ToddBailey/WTPA2/README.md

WTPA2
=====

Home of "Where's The Party At 2" code and project resources since October 2013
