ToddBailey/WTPA2/hardware/WTPA2_PCB.png

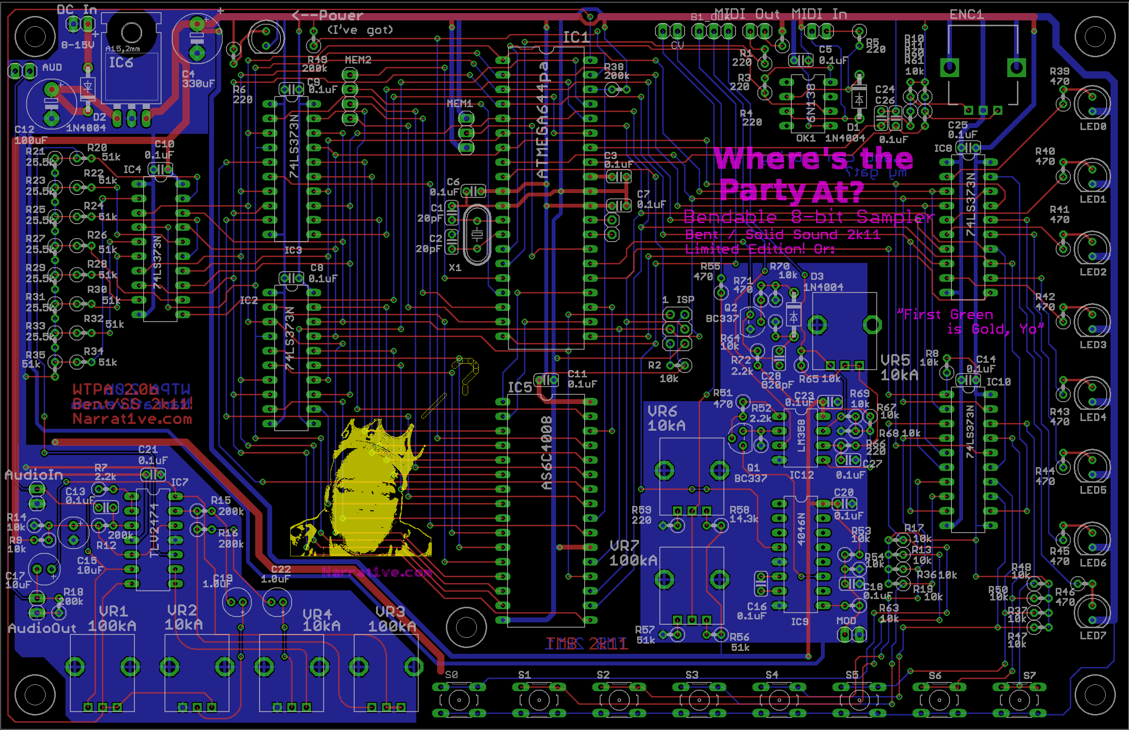
hardware/WTPA2_PCB.png
