ToddBailey/WTPA2/hardware/WTPA2_Schematic_P1.png

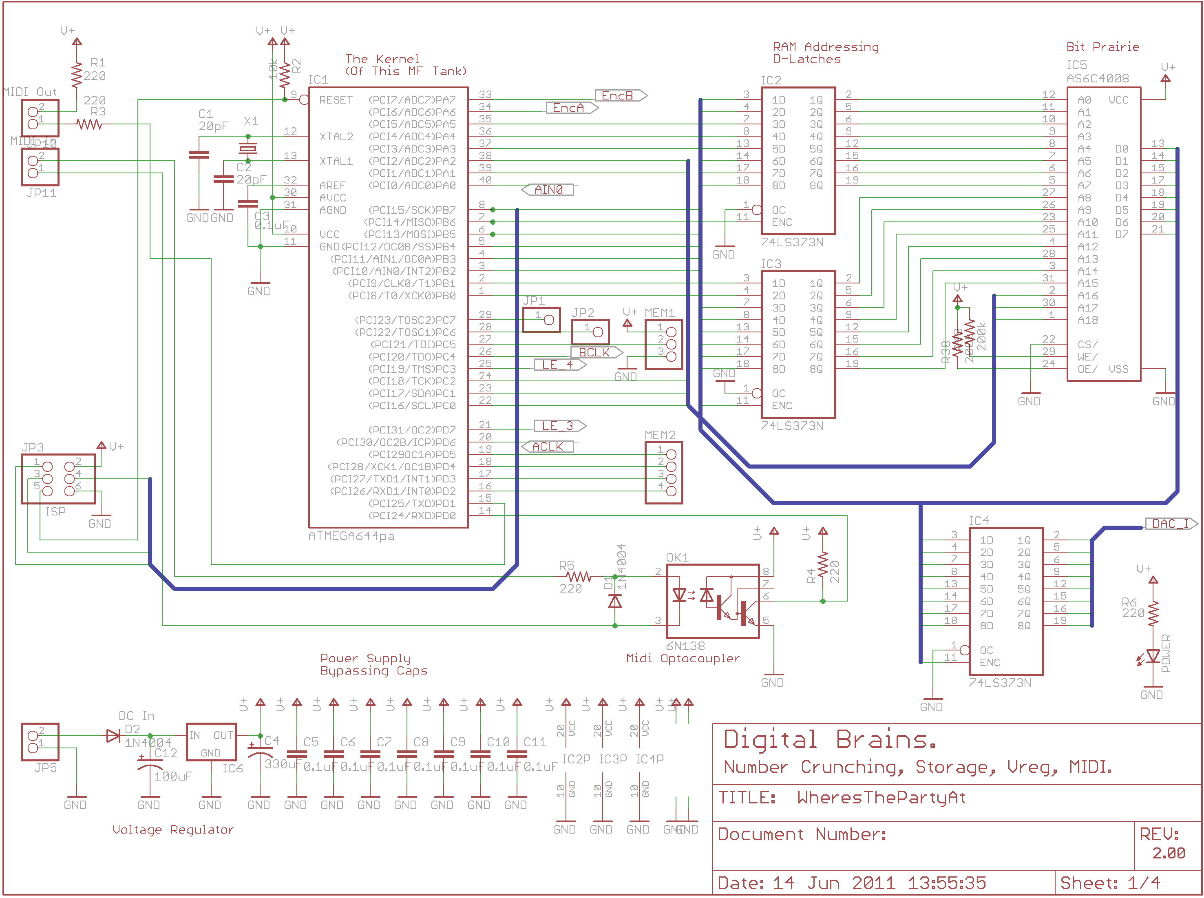
hardware/WTPA2_Schematic_P1.png
