ToddBailey/WTPA2/hardware/WTPA2_Schematic_P2.png

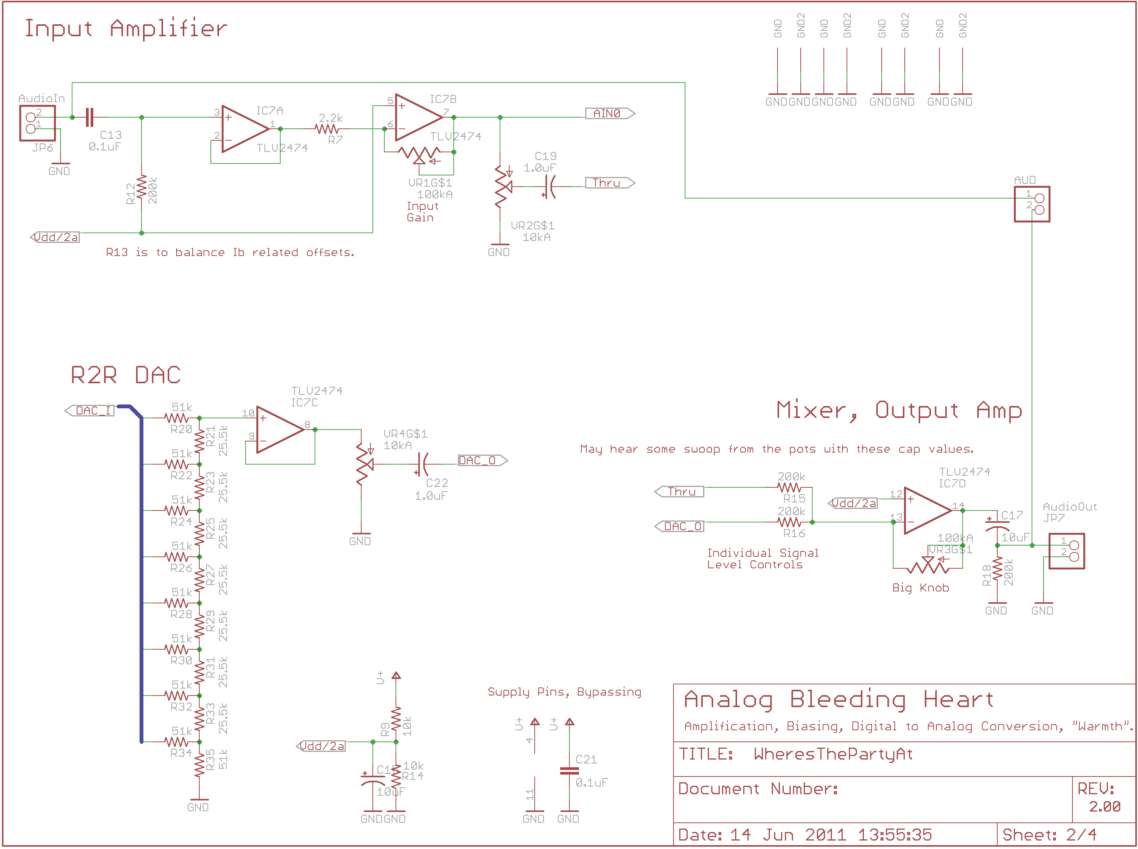
hardware/WTPA2_Schematic_P2.png
