ToddBailey/WTPA2/hardware/WTPA2_Schematic_P3.png

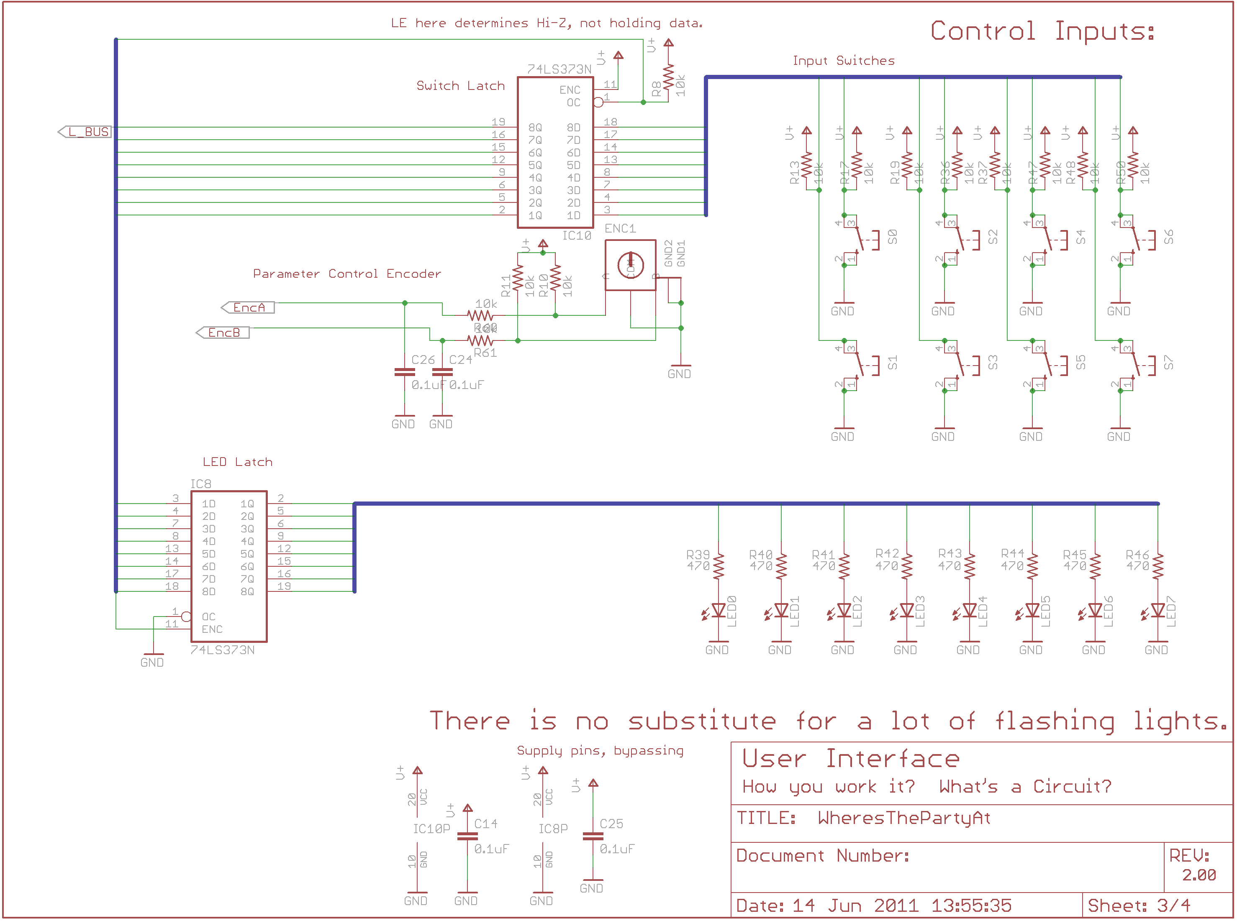
hardware/WTPA2_Schematic_P3.png
