ToddBailey/WTPA2/hardware/WTPA2_Schematic_P4.png

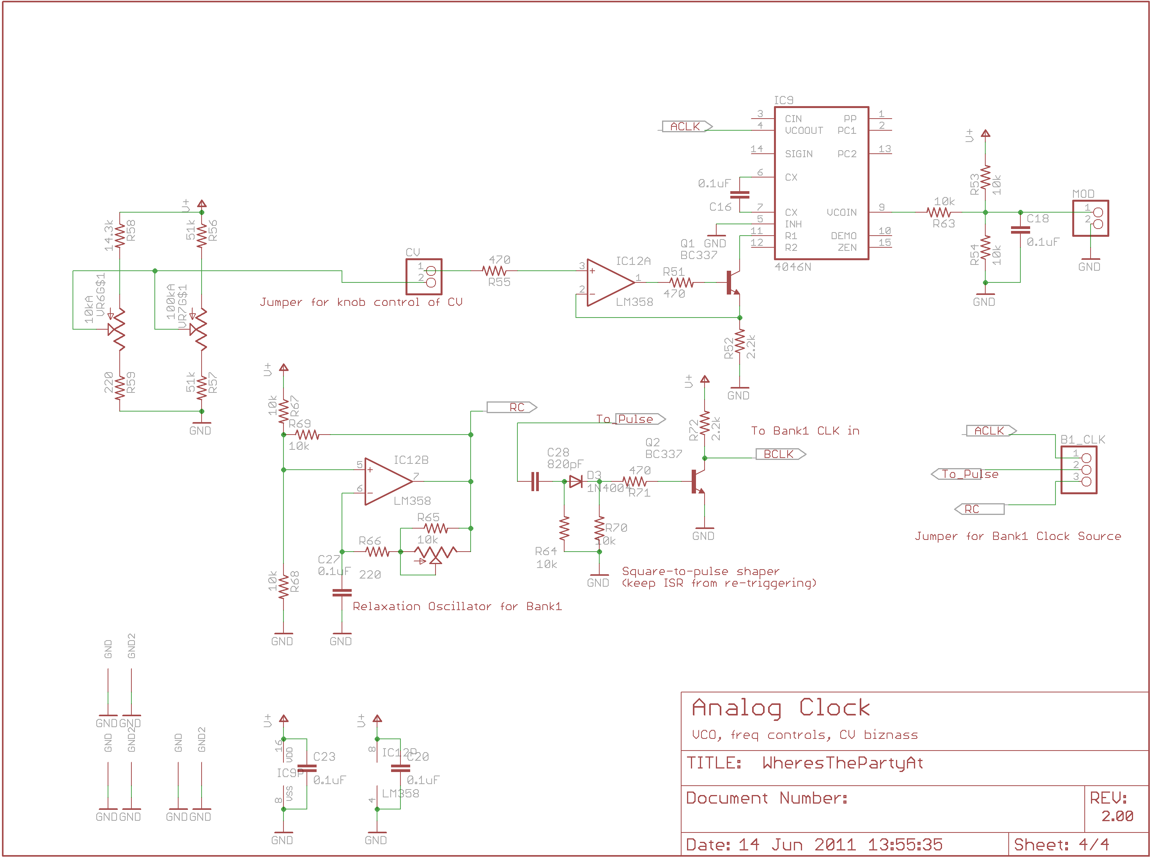
hardware/WTPA2_Schematic_P4.png
