ToddBailey/WTPA2/docs/WTPA2_Component_Guide_RevA.pdf

## WTPA2 Component Guide

(a gentle guide for the trepidatious) First Revsion (Rev A)
December 7 2014
TMB

This is basically a big set of descriptions and pictures of WHAT and HOW MANY of those whats go into a single WTPA2 kit.
This doc isn't really about theory or about how to use WTPA2, it's just what goes into it and a very little about the components involved. So without further adieu here's what goes in WTPA2, divided up by type of component.
The component type and value explain what the thing is, and the reference designator is the part's name in the schematic and on the printed circuit board.
Quantity per board ought to be pretty self explanatory.

Note: if you like paper printouts it might help to have this list in hand while you're building the kit. Sometimes I like that.

Note: THE MOST IMPORTANT THING YOU SHOULD TAKE AWAY FROM THIS DOC if you aren't already familiar with electronics: some components are POLAR. Namely, the diodes and some of the electrolytic capacitors. POLAR components need to maintain a certain orientation with respect to voltages. What this means for the kit-builder is that although the polar components CAN fit into the board one of two ways, one way is backwards, and bad things will happen either immediately or down the road if you put them in the wrong way.

The board has markings on the caps and diodes to help you remember this.

(Note: you can always find the most recent WTPA2 notes on www.narrat1ve.com if this doc gets outdated, or just if you're curious).

## WTPA2 Component List

Qty: | Value: | Reference Designators:

Capacitors:
1 | 100uF | C12
1 | 330uF | C4
19 | 0.1uF | C3, C5, C6, C7, C8, C9, C10, C11, C13, C14, C16, C18, C20, C21, C23, C24, C25, C26, C27
2 | 10uF | C15, C17
2 | 1.0uF | C19, C22
1 | 820pF | C28
2 | 20pF | C1, C2

Resistors:
25 | 10k | R2, R8, R9, R10, R11, R13, R14, R17, R19, R36, R37, R47, R48, R50, R53, R54, R60, R61, R63, R64, R65, R67, R68, R69, R70
11 | 51k | R20, R22, R24, R26, R28, R30, R32, R34, R35, R56, R57
11 | 470 | R39, R40, R41, R42, R43, R44, R45, R46, R51, R55, R71
7 | 25.5k | R21, R23, R25, R27, R29, R31, R33
7 | 220 | R1, R3, R4, R5, R6, R59, R66
6 | 200k | R12, R15, R16, R18, R38, R49
3 | 2.2k | R7, R52, R72
1 | 14.3k | R58

Ics/Semis:
9 | LEDs | LED0, LED1, LED2, LED3, LED4, LED5, LED6, LED7, POWER
5 | 74HC373 | IC2, IC3, IC4, IC8, IC10
3 | 1N4004 | D1, D2, D3
2 | BC337 | Q1, Q2
1 | Atmega644p/a | IC1
1 | IC socket for above | (no designator)
1 | AS6C4008 | IC5
1 | 7805 | IC6
1 | LM358 | IC12
1 | TLV2474 | IC7
1 | 6N138 | OK1
1 | 74HC4046N | IC9

Pots/Enc:
4 | 10kA | VR2, VR4, VR5, VR6
3 | 100kA | VR1, VR3, VR7
1 | RE111F | ENC1

Mech/Xtal:
8 | 17mm Tact | S0, S1, S2, S3, S4, S5, S6, S7
1 | 20MHz XTAL | X1
1 | ISP Header | ISP

Now, here's what all these different parts look like in schematic representation. I used to be really good about drawing pretty pictures, but now I just jack things from the internet like everybody else:

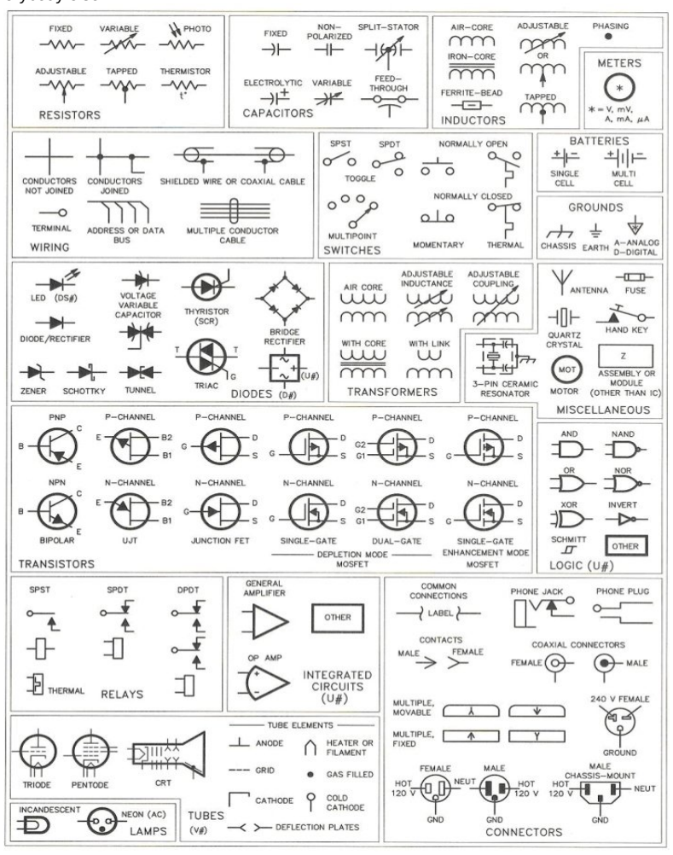
[picture p8: figure]

Don't take that chart too seriously, though. An op-amp hasn't had that weird curve in the back since Widlar was giving sheep to bartenders. If you want to try and figure out what's going on in the schematics, you'll need to know these symbols. Since debugging a messed up kit often involves that, I've included that chart. If you don't know, now you know.

PHYSICAL REPRESENTATIONS:

So now I know what I've got for WTPA2 and what it looks like on paper, so what is it in real life? It all starts with:

The Bare Board:
This is the roadmap where you put all the parts, and makes all the electrical connections. It's basically two layers of flat copper, cut into traces, with a layer of fiberglass in between, and a protective soldermask covering applied (black for WTPA2 but often green) There's a silkscreen on this one, too – it helps you understand where everything goes and lets me make corny jokes. It should (probably) look like this when you get it:

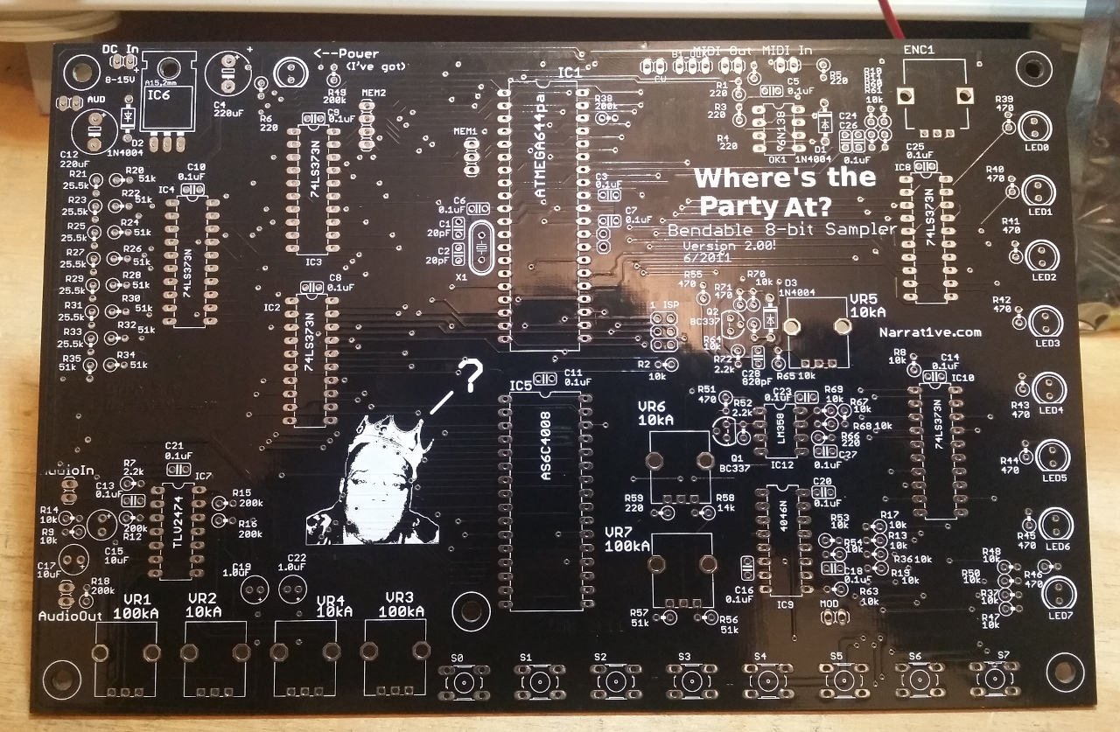
[picture p9: figure]

CAPACITORS:
There are two general types of capacitors in WTPA2, ceramic and electrolytic. Their names refer to what's inside of them and they imply some characteristic differences. But for our purposes, they're the little yellow guys (ceramic) and the cans (electrolytic).

Ceramic:

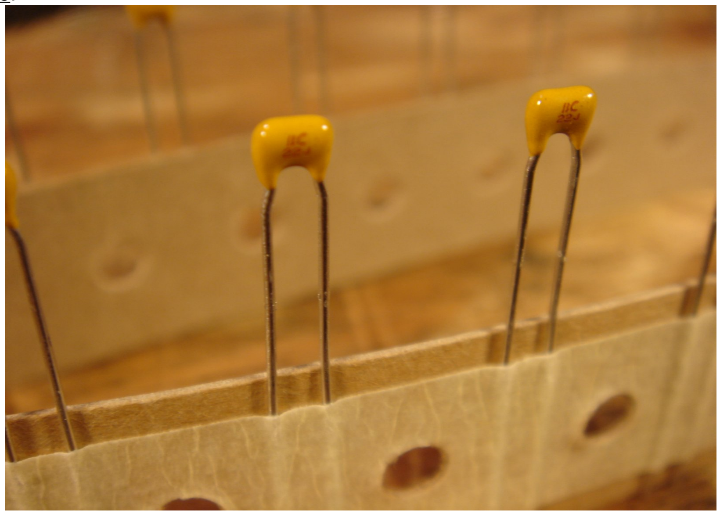
[picture p10: figure]

There are several values of ceramic capacitors in WTPA2. Most are 0.1uF – there are lots of them. 0.1uF caps are common on many boards – they are often used for power supply filtering (we call it bypassing). The two 20pFs are used to stabilize the crystal oscillator. Ceramic caps are never polar as far as I know.

Electrolytic:

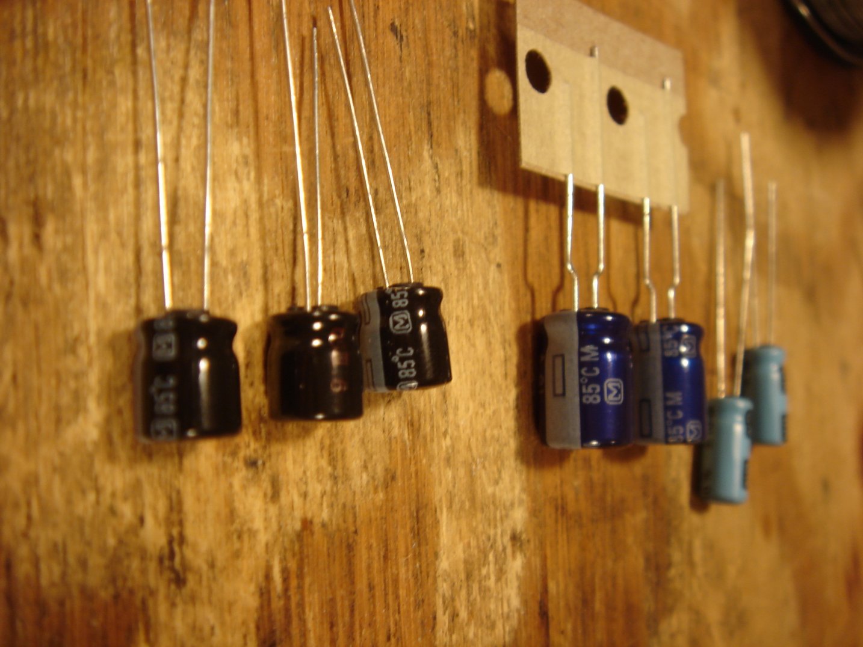
[picture p11: figure]

Electrolytic caps look like this. The colors aren't important, the numbers are. They'll all be labeled. The big guys are the main power supply filters, the 22uFs are filters for analog references and also the audio output AC coupling, and the 1.0uF caps are inter-stage audio coupling caps.

Most electrolytic caps are polar! Most electrolytics in WTPA2 are no exception, but the 1.0uF is not polar (fancy because I love you).

The PCBs are marked with a + where the positive lead of the cap should go, and the caps themselves have a stripe with a – running down the side above the negative lead.
Note: If you want to sound smart and impress the Swedish Bipolar Bikini Team you'll call the “positive lead” the anode and the “negative lead” the cathode.

Sockets and ICs:

Are like peas in a pod. WTPA2 has one socket for the MCU. You don't NEED to use the socket at all, but if you haven't done much with electronics before I recommend that you do. Sometimes sockets are helpful, and sometimes detrimental, but the job of sockets is to allow you to change chips. They also make it impossible to damage an IC when soldering it, because you don't solder it. In WTPA2 you might change chips to try new experiments, you might change chips to upgrade firmware, or you might change chips because you broke one when bending.

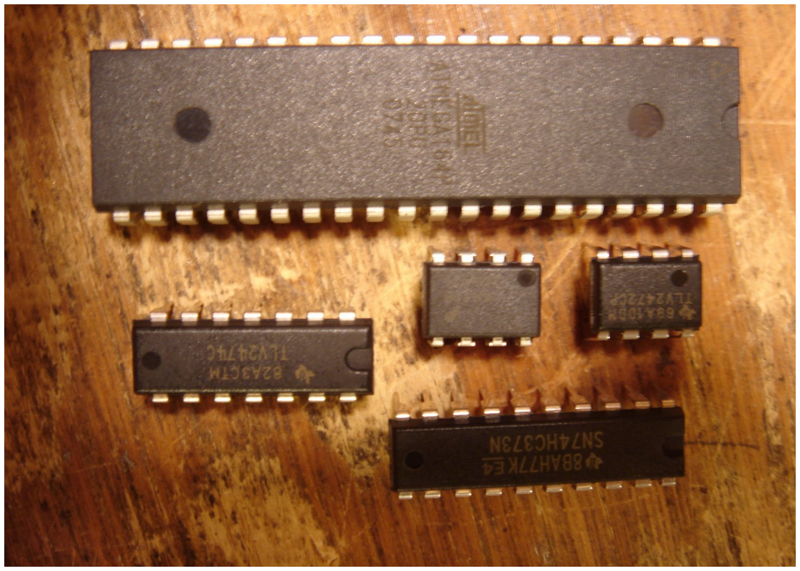
[picture p12: figure]

ICs look like this. IC stands for “integrated circuit”. They are more frequently called “chips”. They are basically very tiny groups of transistors organized to do very specific functions – one chip on WTPA2 might have many thousands of transistors.

The ICs themselves do all the heavy lifting in the chip. The 40-pin guy is the microcontroller (the brain), and the 20-pin guys are parallel latches which allow the microcontroller to effectively have more output pins. The 32 pin chip is the memory chip where the samples are stored (it's called SRAM – Static Random Access Memory). The 14-pin guy is a quad op-amp and is responsible for all the audio amplification and level shifting. One 8-pin IC is a dual op-amp that is configured as an oscillator and used as the alternate analog clock source, and the other 8-pin chip is an optocoupler, which lets WTPA2 receive MIDI messages. The 16-pin IC is a PLL which is a very complicated chip, although we just use it as an easy VCO.

There are two transistors in WTPA2 also. They are tiny three terminal devices, the likes of which make pretty much everything in the modern world possible. Pour one out for Bardeen, Brattain and Shockley.

Diodes, the Crystal, the Regulator, Switches:

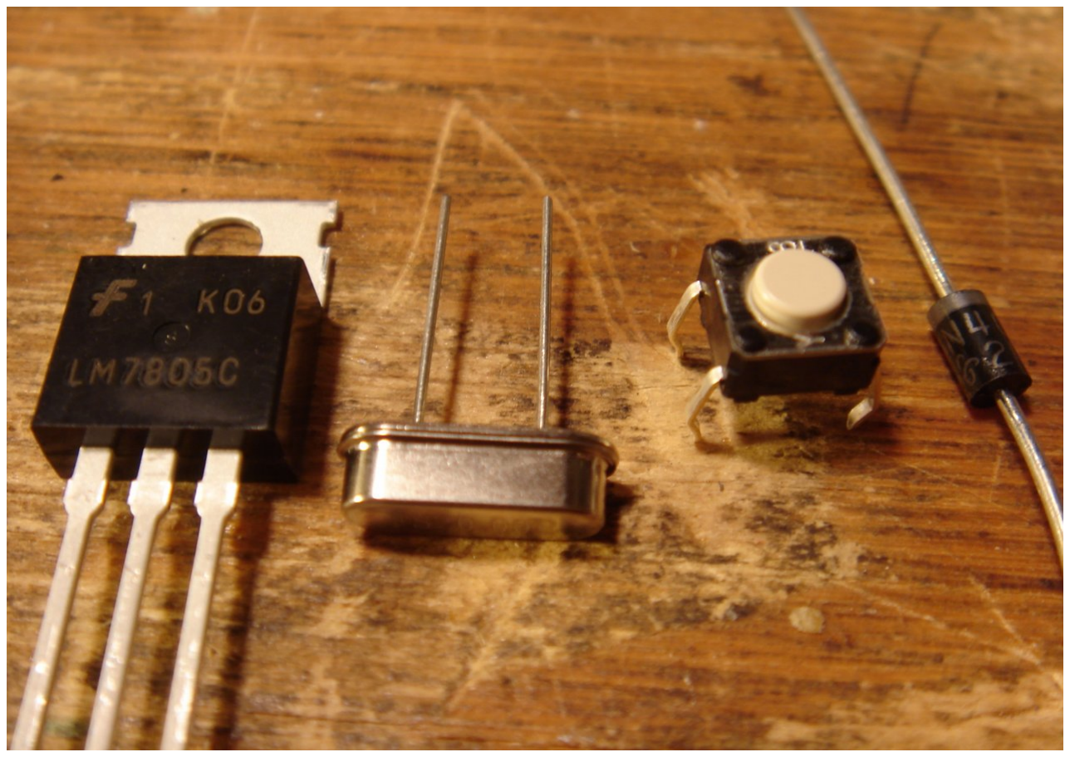
[picture p13: figure]

These components are sort of a miscellany. The regulator is really an IC (again) but (again) I took a picture of it because it looks different. The crystal (the silver guy) is what lets the microcontroller generate an accurate clock for its CPU. The switches are for user input (the ones in WTPA2 are taller). The diodes (WHICH ARE POLAR) are used to protect WTPA2 from hooking up power and inputs incorrectly. The bar on one side (the cathode or “negative side”) goes in the direction of the arrow on the PCB.

LEDs:

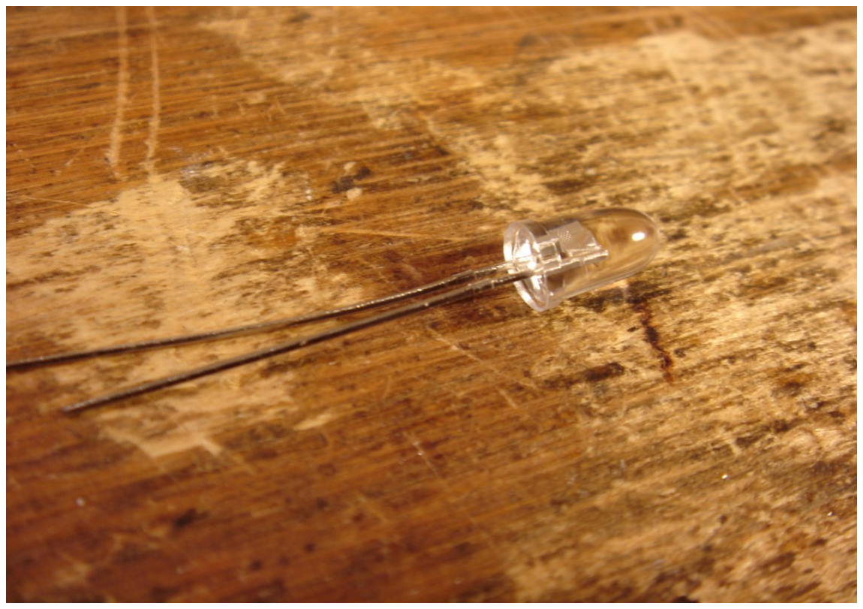
[picture p14: figure]

LED stands for Light Emitting Diode. Like our other diodes, it goes in one way (it's POLAR) Unlike our other diodes, it lights up!

The LONG LEAD on the LED is the anode (positive). It is oriented towards the top of the PCB everywhere in WTPA2. There is also a flat on the other side of the LED (the cathode) which matches the diagram on the PCB.
NOTE: Don't test the polarity of LEDs by hooking them up to a battery (or the power supply) to see if they glow. Backwards they won't glow, but forwards they'll burn out immediately and also not glow.

Potentiometers (and Encoders):

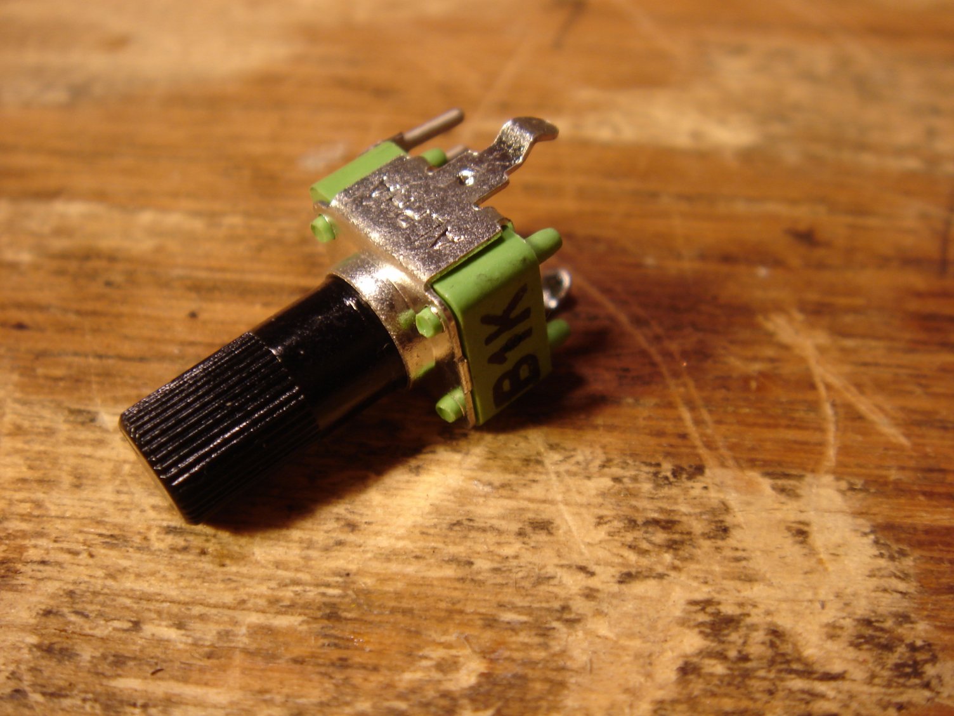
[picture p15: figure]

Potentiometers are often called pots. These are variable resistors which internally wipe copper leaf over a carbon strip. They let us adjust electrical parameters by changing the a resistance ratio inside the component. THERE ARE 2 KINDS OF POTS IN WTPA2 but physically they look very similar! You've got to read the text to tell them apart.

WTPA2 has 100kA pots and 10kA pots. The one pictured above is NOT actually in the kit (I just had the picture laying around). We can see that this pot says B1K (not to be confused with B2K). This means it is a linear taper 1-kilo-ohm potentiometer. The “A” part of 100kA means “Audio Taper” or “has a logarithmic resistance curve as you turn it”.

An encoder is a “digital” device. It looks like a pot but works differently. It has 2 switches inside which open and close as you rotate it. These switches send a pulse train to the microcontroller which tells it how fast and in what direction the encoder is turning. One difference between pots and encoders is that encoders usually have “endless” rotation, meaning they just keep spinning. However, they have no “absolute” value, they can only tell the MCU how much they've traveled – not where they started.

The encoder in WTPA2 is the thing that looks like a pot with a metal shaft which spins freely.

Resistors:
There are 8 kinds of resistors in WTPA2 – some are blue 1% metal film resistors and some are tan 5% carbon-film resistors. They do ALL kinds of stuff in WTPA2. The 1% resistors are less noisy (audio wise) and have a better tolerance which is sometimes important. ALL of the resistors have values which are conveyed by their color code. The resistor color code is outside the scope of this doc, but suffice it to say that the code IS DIFFERENT for the 1% and 5% resistors. It's really easy to find these codes on the internet. Do yourself a favor and memorize them. But here are some examples, just to be helpful:

220 Ohm

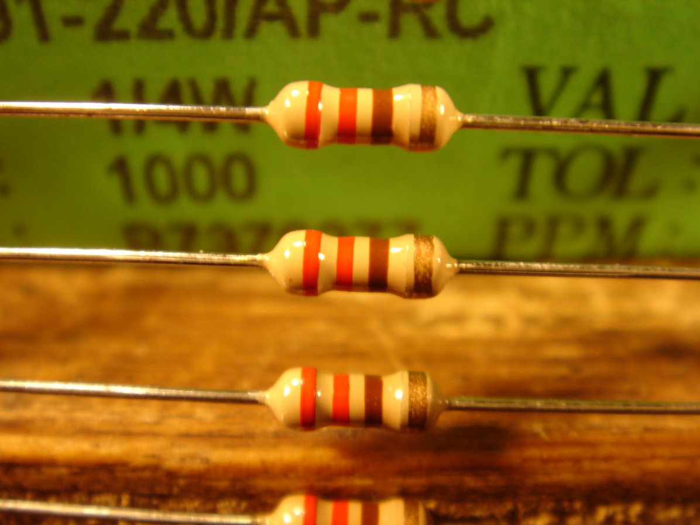
[picture p16: figure]

The code for these is RED RED BROWN GOLD. (22 * 10 +/- 5%)

470 Ohm:

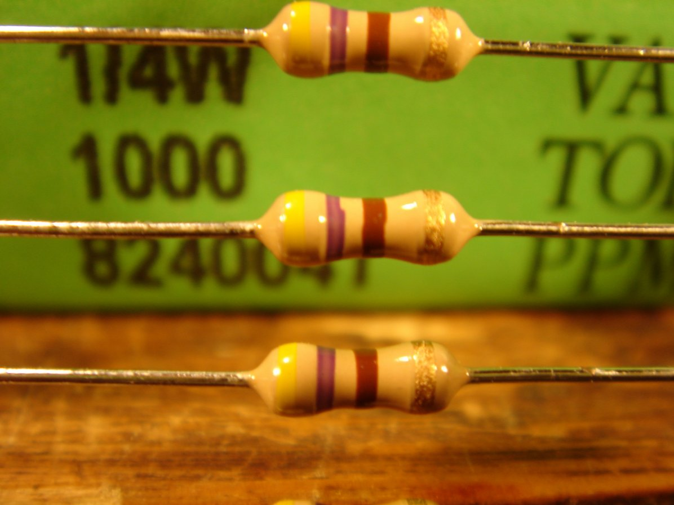
[picture p17: figure]

The code for these is YELLOW PURPLE BROWN GOLD. (47 * 10 +/- 5%)

200k Ohm:

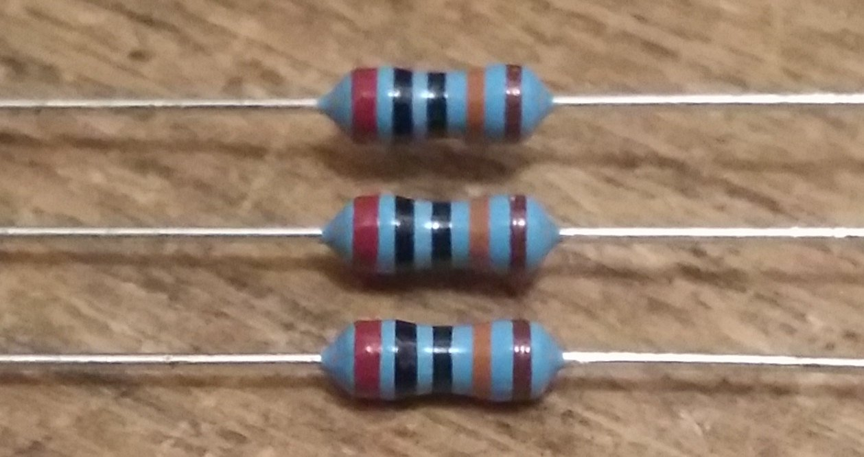
[picture p18: figure]

This is a 1% resistor. It has 5 bands. The code for this value is (RED BLACK BLACK) * ORANGE, BROWN. (200 * 1000 +/- 1%) = 200kOhms.

Conclusion:
So hopefully this has familiarized you with the denizens of the WTPA2 universe. You now know what's in your kit, and what it looks like, and some rules about some components. You've got some good information to start with, but there's a lot more. At www.narrat1ve.com there should be more info on ASSEMBLING the kit, using it, and perhaps most importantly, HOW IT ALL WORKS. Good luck!

--TMB, December 5 2014
