ToddBailey/WTPA2/(threads)

Thread 1 (2015-01-06):

MIDI playback continues looping

ToddBailey, 2015-01-06:
Playing via MIDI, if a NOTE_OFF isn't received in a certain time window, the sample will loop.
Further, the next NOTE_ON does not always result in a new playback.

Seems to be related to how long a key is held (TMB found this)

ToddBailey, 2015-01-07:
Hardware problem with a single unit, not a bug.

Closed 2015-01-07.
