ToddBailey/WTPA2/application/WTPA.c

// Where's the Party At?
// VERSION 2 DA EMPIRE STRIKES BLACK
// ==================================
// Todd Michael Bailey
// todd@narrat1ve.com
// Tue Jul  6 19:36:23 EDT 2010

#include	"includes.h"
#define		CURRENT_FIRMWARE_VERSION	0x13		// Starts at 0x10 for WTPA2.  0x11, messing around from 2011-2013, 0x12 github pre-release version
													// 0x13 -- Audio bootloader, application code starting November 2014

//=============================
// HOLLER-WARE LICENSE:
// Todd Bailey wrote this.  Do whatever you want with this code, but holler at me if you like it, use it, got a nice ride / big ol' butt, or know how to do it better.
// xoxoxo
// bai1ey.tm@gmail.com
//
// Todd Bailey would like to take this opportunity to shout out to:
//
// Todd Squires, who continues to be wholly intolerant of my bad programming habits and whose TB4 OS and libraries inspired most of this,
// Andrew Reitano for the Nintendo sample playback code,
// Olivier Gillet for the code review, some great ISR speed suggestions, harping on me about removable memory, and generally being a mensch,
// Nick Read, Daniel Fishkin, and Charlie Spears for slangin solder and et cet,
// ChaN for the awesome page on SD interfacing,
// Limor Fried and Phil Torrone, for staying on my ass about making kits,
// Glitched, Dan Nigrin, Altitude, Rodrigo, Sealion, and everybody else on the Narrat1ve forum for contributing ideas, docs, samples, and everything else.
// BMT Toys and everybody there for putting me through the embedded-systems wringer for all those years of programming challenges, and for putting up with my chronic lateness and body-odor,
// Jim Williams, Paul Horowitz, Winfield Hill, and all the other people who've forgotten more than I'll ever know about all things analog,
// and most importantly,
// You, the Customer.
//=============================

//=============================
// Atmel AVR Atmega644p MCU, 5v operation.
// 20MHz Crystal Oscillator.
// Last build:
// AVR_8_bit_GNU_Toolchain_3.4.2_939
// Likely from the Atmel site
// AVR-Binutils 2.23.1
// AVR-GCC 4.7.2
// AVR-libc 1.8.0
//==============================

/*
Description:
==============================================================================
Just rock out, you know?
The real description for lots of this sampler is in the manuals.

Technical descriptions of just about everything can be found by grepping through the code comments.
It might be worth your time to check out the original WTPA code as well as the WTPA2 code.


Changelog:
==============================================================================
==============================================================================
Made a CHANGELOG file in this directory.  Only valid for WTPA2 changes once releases start.  You'll have to dig for old changes.

*/

// I hate Prototypes:
static void DoFruitcakeIntro(void);
static void StartPlayback(unsigned char theBank, unsigned char theClock, unsigned int theRate);
static void StartRecording(unsigned char theBank, unsigned char theClock, unsigned int theRate);
static void PlaySampleFromSd(unsigned int theSlot);
static void UpdateAdjustedSampleAddresses(unsigned char theBank);
static void InitSdIsr(void);
static void DoSampler(void);
static void InitDpcm(void);

//-----------------------------------------------------------------------
//-----------------------------------------------------------------------
// Lists:
//-----------------------------------------------------------------------
//-----------------------------------------------------------------------

// Audio ISR States -- these are the different things we can do in the audio related ISR.
//---------------------------------------------------------------------------------------

enum
	{
		AUDIO_IDLE=0,
		AUDIO_SAWTOOTH,
		AUDIO_REALTIME,
		AUDIO_RECORD,
		AUDIO_PLAYBACK,
		AUDIO_OVERDUB,
		NUM_AUDIO_FUNCTIONS,
	};


// LEDs.
//-----------------------------------------------------------------------
enum					// LED enum used for keeping track of our LED masks.
	{
		LED_0=0,
		LED_1,
		LED_2,
		LED_3,
		LED_4,
		LED_5,
		LED_6,
		LED_7,
		NUM_LEDS,
	};

// WTPA has gotten to the point where each LED pretty much corresponds to an indicator of something specific.
// To reflect this, the masks here arrange LEDs by FUNCTION, to make code easier to read.

#define	Om_LED_REC			(1<<LED_0)
#define	Om_LED_ODUB			(1<<LED_1)
#define	Om_LED_PLAY			(1<<LED_2)
#define	Om_LED_OUT_OF_MEM	(1<<LED_3)	// @@@ lose this guy.
#define	Om_LED_BANK			(1<<LED_4)
#define	Om_LED_FX2			(1<<LED_5)
#define	Om_LED_FX1			(1<<LED_6)
#define	Om_LED_FX0			(1<<LED_7)

static unsigned char
	ledOnOffMask,		// What leds are on and off now?
	ledBlinkMask;		// What leds are blinking right now?

static volatile unsigned char
	ledPwm;				// Used for our benighted intro.

//-----------------------------------------------------------------------
//-----------------------------------------------------------------------
// Application Globals:
//-----------------------------------------------------------------------
//-----------------------------------------------------------------------

// Keys and switch variables
//-----------------------------------------------------------------------
static unsigned char
	keyState,
	newKeys,
	keysHeld;

static bool
	cardDetect;		// Is SD card physically in the slot?

// Application flags and housekeeping.
//-----------------------------------------------------------------------
STATE_FUNC				//  Creates a pointer called State to an instance of STATE_FUNC().
	*State;
static unsigned char
	subState;			//  Keeps track of the minor states (sub states) the device can be in.

static volatile bool
	outOfRam;				// Goes true in the ISR if we run out of RAM.

static bool
	newEncoder,				// Has the encoder moved this loop?
	encoderCw,				// Goes true for one loop if the encoder has turned clockwise or counterclockwise.  Useful for incrementing and decrementing other things besides the encoder's absolute value
	encoderCcw;

static unsigned char
	encoderState,			// What the encoder switches look like.
	encoderValue,			// Incremental ticks on the encoder.
	scaledEncoderValue;		// The number that we display on the LEDs and use to select different effects and stuff.  Generated from the encoder reading.

static bool
	dpcmMode;				// Doing the DPCM loop?

// Granular stuff
//-----------------------------------------------------------------------

#define	JITTER_VALUE_MAX	127

static unsigned long
//	random31 __attribute__((section(".noinit")));	//32 bit random number, seeded from noinit sram (so it comes up a mess, in theory)
	random31=0xBEEF;								// No chance to come up zero because we threw out init code.

enum	// Flags we use to determine what to set our clock source to when setting up an audio interrupt.
{
	CLK_NONE=0,
	CLK_EXTERNAL,
	CLK_INTERNAL,
};


// ADC globals:
//-----------------------------------------------------------------------
static volatile signed char
	adcByte;			// The current reading from the ADC.

// SD Card Globals:
//-----------------------------------------------------------------------

#define SD_WARMUP_TIME							(SECOND)		// SPEC is 250mS but why not be safe.
#define	SD_BYTES_PER_PARTIAL_BLOCK_TRANSFER		(64)			// We leave our SD card open while reading blocks, and read a partial block at a time so we don't hang the state machine for too long and miss MIDI/Encoder stuff.  This number is how much of a block we read at a time.
#define	SD_FIFO_SIZE							(SD_BLOCK_LENGTH+(SD_BLOCK_LENGTH/2))	// AVR's RAM fifo for reads and writes is one and a half blocks.

static unsigned char
	cardState;					// Keeps track of what's going on with the SD Card -- reading, writing, not present, etc.
static unsigned char
	sampleToc[64];				// Local RAM copy of the card's table of contents (where the samples are stored)
static volatile signed char
	sdFifo[SD_FIFO_SIZE];		// Rolling buffer for getting bytes in and out of the SD card with the state machine.  NOTE -- contains samples (ADC data) so must be signed.

static volatile unsigned int		// FIFO pointers for the SD card read/write buffer.
	sdFifoReadPointer,
	sdFifoWritePointer,
	sdBytesInFifo;

// The below are variables used by the SD state machine and functions:
//static unsigned char
//	sdQueuedBank;		// Bank to play pending stream from SD card on
static unsigned int
	sdQueuedSlot;		// Pending sample to play once the current stream is closed
static bool
	sdPlaybackQueued,	// Is there a playback we need to immediately start once the current SD abort finishes, or should we just go back to idle?
	sdAbortRead;		// Should the SD state machine abort a read in progress?

static unsigned long
	sdSampleStartBlock;
static volatile unsigned long
	sdRamSampleRemaining,		// Decrements as we write/read samples to/from RAM until we're done.
	sdCardSampleRemaining;		// Decrements as we write/read samples to/from the sd card until we're done.

static unsigned int
	sdCurrentSlot,
	sdCurrentBlockOffset;

enum					// All the things the micro sd card state machine can be doing
	{
		SD_NOT_PRESENT=0,
		SD_WARMUP,
		SD_JUST_INSERTED,
		SD_WRITE_START,
		SD_WRITING_BLOCK,
		SD_WRITE_CARD_WAIT,
		SD_WRITE_FIFO_WAIT,
		SD_TOC_WRITE_START,
		SD_TOC_WRITE_CONTINUE,
		SD_TOC_WRITE_FINISH,
		SD_READ_START,
		SD_READING_BLOCK,
		SD_READ_FIFO_WAIT,
		SD_READ_TOKEN_WAIT,
		SD_READ_ABORT,
		SD_IDLE,
		SD_INVALID,
	};

// Variables which handle the SD card's ISR.  These generally keep track of the on-chip buffer for SD data, and where it might be going in external RAM.

static unsigned char
	sdIsrState;					// Keeps track of what the IRQ that deals with data coming off / going to the SD card is doing (ie, writing SRAM, reading)
static unsigned long
	sdRamAddress;				// Used to point to the spot in RAM where the data from the sd card is coming or going
static bool
	sdBank0;					// Tells us whether the SD buffer is messing with the RAM in sample bank 0 or 1.

enum					// All the things the micro sd card's interrupt can be doing
	{
		SD_ISR_IDLE=0,
		SD_ISR_LOADING_RAM,
		SD_ISR_READING_RAM,
		SD_ISR_STREAMING_PLAYBACK,
	};

static unsigned int
	midiSdSampleOffset=0;		// Offset for MIDI NOTE numbers for the SD Streaming playback channel, set to allow access to all 512 samples on an SD card

//-----------------------------------------------------------------------


//----------------------------------------------------------------------------------------------------------------------------------------------
//----------------------------------------------------------------------------------------------------------------------------------------------
//----------------------------------------------------------------------------------------------------------------------------------------------
// Da Code:
//----------------------------------------------------------------------------------------------------------------------------------------------
//----------------------------------------------------------------------------------------------------------------------------------------------
//----------------------------------------------------------------------------------------------------------------------------------------------

typedef void CALLBACK_FUNCTION(volatile BANK_STATE *theBank);	// Creates a function datatype with that is passed a pointer to a bank as the input argument

CALLBACK_FUNCTION		// Instantiations of callback functions
	*AudioCallback0,
	*AudioCallback1;

enum	// Ways we can recombine the audio before we send it out the DAC
	{
		OUTPUT_ADD=0,
		OUTPUT_MULTIPLY,
		OUTPUT_XOR,
		OUTPUT_AND,
		OUTPUT_SUBTRACT,
	};

static signed char
	sdStreamOutput;		// Contribution to DAC coming directly off the SD card
static unsigned char
	outputFunction,		// How should we combine the audio outputs of the banks before sending them out?
	lastDacByte;		// Very possible we haven't changed output values since last time (like for instance we're recording) so don't bother strobing it out (adds noise to ADC)

static void PlayCallback(volatile BANK_STATE *theBank)
// NOTE -- for the record, before you started messing around (Oct 2013):
//		Playback ISR speed:		About 13.1-13.2uS
//		Record ISR speed:		About 11.45uS
// Wed Nov  6 12:55:16 EST 2013
//		As of last push:
//		Playback ISR time:		7.80uS
//		Rec ISR time:			6.50uS
// Adding half time:
//		Play					8.25uS (9 cycles added)

// NOTE -- callbacks for different audio functions can allow us to combine output bytes more efficiently I think
// Old functions summed 4 things -- contributions from MIDI for each bank and contributions from the oscillator clocked ISRs for each bank.
// New functions can include an "output byte" in the bank datastructure and just use that, since a given bank can only really generate one output at a time
// Call output callback from play/odub/saw BUT NOT record, too?
// NOTE -- Pretty sure cycle eaters include:
//			Pushing and popping registers when calling functions and entering/returning from ISRs
//			Any 32-bit operation (including increments)
//			Branching
//			The compiler is real dumb about loading 32-bit numbers when it doesn't need to.  It can't pull 8 bits out of a 32-bit number without loading the whole number for instance.
//			--	So, there would be a lot of room for improvement via assembly
//			The compiler is smart enough to toggle a bit when strobing latch lines (one command)
//			A comparison to boolean false (zero) is also a single command (and a branch in an if statement), so it's fast
// NOTE -- Saving the address in a local variable and makes the compiler about the address lookup.  Judicious use of casting to a byte-sized datatype sometime helps too.
//			Could write the RAM read in assembly and make it alot faster
// NOTE -- The generated disassembly when pointing to a bank is the same as the assembly when the BANK_0 address is hardcoded WHEN we only call this function with BANK_0.  Smart compiler.

// Can we replace the audioFunction variable with a check of the Callback function?  Think so.
// Make "slice" vars associated with bank structure

// @@@ maybe remove "half speed" variable -- perhaps include speed divisions as an option now

// NOTE -- instead of comparing to ending address each sample to see if a loop is done, could we perhaps decrement the amount of sample remaining?
// This involves decrementing and comparing a 32 bit number to zero rather than comparing two 32 bit numbers.
// NOTE -- Initial looking at the LSS files show the dec/compareZ to be slower (17cy vs 13cy)
// NOTE -- this is how granular does it right now.  It would however allow us to skip individual samples more easily (ie -- INCREASE sample speed): we could dec the "remaining" counter by the "increment" amount and check to see if it went negative
//		This would allow us to decrement by 2, say and not worry if we missed targetAddress

// Thu Nov  7 11:52:24 EST 2013
//	Tried implementing bank combinations as a function call.  Started a new branch.  It was slower by about 1.5-1.75uS (about 10uS playback)
//	Came back to switch model
// Thu Nov  7 13:09:23 EST 2013
//	Found that an if-else was faster (at least where ADD was concerned) assuming the optimizer flag was -O2 or -O3
//	Currently ~75% of the loops are at 8uS and the rest are at 7.7uS

// Thu Nov  7 14:54:34 EST 2013
// Added in granularity to playback again.
// Currently ~75% of the loops are at 8.6uS and the rest are at 8.3uS
// So we lost 600nS (12 cycles) including the granularity in the regular playback routine.
// We can break it out to a new callback if needed...

// Thu Nov  7 18:14:35 EST 2013
// Change out of RAM light to an SD card access light

// Thu Nov  7 18:36:06 EST 2013
// Edit start/end/window stuff is still screwy, check it out.

// Fri Nov  8 12:41:17 EST 2013
// Looks like granular array stuff is based on FULL samples, should be able to apply it to edited samples too

{
	// Goes through RAM and spits out bytes, looping (usually) from the beginning of the sample to the end.
	// The playback ISR also allows the various effects to change the output.
	// Since we cannot count on the OE staying low or the AVR's DDR remaining an input, we will explicitly set all the registers we need to every time through this ISR.

	// Read memory (as of now all audio functions end with the LATCH_DDR as an output so we don't need to set it at the beginning of this function)

	unsigned long
		theAddy;	// Using a local nonvolatile variable allows the compiler to be smarter about the address resolution and not load a 32-bit number every time.
	signed int
		sum0;		// Temporary variables for saturated adds, multiplies, other math.
	unsigned char
		dacOutput;		// What to put on the DAC

	if(theBank->sampleSkipCounter)		// Used for time division
	{
		theBank->sampleSkipCounter--;	// Don't play anything this time around
	}
	else
	{
		theBank->sampleSkipCounter=theBank->samplesToSkip;		// Reload number of samples to skip

		theAddy=theBank->currentAddress;		// Using a local nonvolatile variable allows the compiler to be smarter about the address resolution and not load a 32-bit number every time.

		LATCH_PORT=theAddy;							// Put the LSB of the address on the latch.
		PORTA|=(Om_RAM_L_ADR_LA);					// Strobe it to the latch output...
		PORTA&=~(Om_RAM_L_ADR_LA);					// ...Keep it there.

		LATCH_PORT=(theAddy>>8);					// Put the LSB of the address on the latch.
		PORTA|=(Om_RAM_H_ADR_LA);					// Strobe it to the latch output...
		PORTA&=~(Om_RAM_H_ADR_LA);					// ...Keep it there.

		PORTC=(0xA8|((unsigned char)(theAddy>>16)&0x07));			// Keep the switch OE high (hi z) (PC3), test pin high (PC7 used to time isrs), and the unused pins (PC4-6) low, and put the high addy bits on 0-2.

		LATCH_DDR=0x00;								// Turn the data bus around (AVR's data port to inputs)
		PORTA&=~(Om_RAM_OE);						// RAM's IO pins to outputs.

		// Calculate new addy while data bus settles

		// Granular:
		// ---------------------------------------------------------------------------
		if(theBank->granularSlices)			// Are we granularizing the playback?
		{
			if(theBank->sliceRemaining--)	// Moving through our current slice?
			{
				theAddy+=theBank->sampleIncrement;		// "Increment" the sample address.  Note, this could be forward or backward and we must be sure not to skip the target address

				if(theAddy==theBank->endAddress)		// Just hit the absolute end?
				{
					theAddy=theBank->startAddress;		// Jump to the start
				}
				else if(theAddy==theBank->startAddress)	// Just hit the absolute start?
				{
					theAddy=theBank->endAddress;		// Jump to the end
				}

				theBank->currentAddress=theAddy;
			}
			else	// Slice done, jump to new slice.
			{
				theBank->sliceRemaining=theBank->sliceSize;		// Reload the slice counter.
				theBank->granularPositionArrayPointer++;		// Point to the next slice in memory.

				if(theBank->granularPositionArrayPointer==theBank->granularSlices)	// Roll around list of slices
				{
					theBank->granularPositionArrayPointer=0;	// Point back at the first slice.
					if(theBank->loopOnce==true)					// If we're only supposed to play once we should be done now.
					{
						theBank->audioFunction=AUDIO_IDLE;
						theBank->clockMode=CLK_NONE;
					}
				}

				if(theBank->startAddress==0)		// Goofy way of checking if this is BANK_0.  Since our offset into the granular array is signed, we need to differentiate banks here.  Perhaps there's a better way to do this
				{
					//theBank->currentAddress=((theBank->granularPositionArray[theBank->granularPositionArrayPointer]*theBank->sliceSize)+BANK_0_START_ADDRESS);	// Loops around un-edited sample

					theAddy=((theBank->granularPositionArray[theBank->granularPositionArrayPointer]*theBank->sliceSize)+theBank->adjustedStartAddress);		// Jump to new chunk relative to edited start address

					if(theAddy>=theBank->endAddress)	// Jumped past end of sample?
					{
						theAddy-=theBank->endAddress;								// Roll around
						theBank->currentAddress=theAddy+theBank->startAddress;		// Add remaining jump to the absolute start
					}
					else
					{
						theBank->currentAddress=theAddy;
					}
				}
				else	// Samples grow downwards (this is annoying)
				{
					//theBank->currentAddress=(BANK_1_START_ADDRESS-(theBank->granularPositionArray[theBank->granularPositionArrayPointer]*theBank->sliceSize));	// Loops around unedited sample
	
					theAddy=(theBank->adjustedStartAddress-(theBank->granularPositionArray[theBank->granularPositionArrayPointer]*theBank->sliceSize));

					if(theAddy<=theBank->endAddress)	// Jumped past end of sample?
					{
						theAddy=(theBank->endAddress-theAddy);						// Roll around
						theBank->currentAddress=theBank->startAddress-theAddy;		// Add remaining jump to the absolute start
					}
					else
					{
						theBank->currentAddress=theAddy;
					}
				}
			}
		}
		// Non-granular playback:
		// ---------------------------------------------------------------------------
		else
		{
			// theBank->currentAddress=(theBank->sampleIncrement+theAddy);	// "Increment" the sample address.  Note, this could be forward or backward and we must be sure not to skip the target address

			// @@@ We don't do this in overdub right now so probably overdub with widowed playback is busted.
			// @@@ I think we're playing one garbage sample looping this way, since we play the sample in the "endAddress" which is not filled in the record ISR.
			// Gotta check for absolute sample ends/beginnings to handle windowed playback, irritatingly
			// Will miss one sample when we roll around this way

			theAddy+=theBank->sampleIncrement;

			if(theAddy==theBank->targetAddress)		// Have we run through our entire sample or sample fragment?
			{
				theBank->currentAddress=theBank->addressAfterLoop;		// We're at the end of the sample and we need to go back to the relative beginning of the sample.

				if(theBank->loopOnce==true)							// Yes, and we should be done now.
				{
					theBank->audioFunction=AUDIO_IDLE;
					theBank->clockMode=CLK_NONE;
				}
			}
			else		// Increment through sample and handle rolling at absolute ends
			{
				if(theAddy==theBank->endAddress)		// Just hit the absolute end?
				{
					theAddy=theBank->startAddress;		// Jump to the start
				}
				else if(theAddy==theBank->startAddress)	// Just hit the absolute start?
				{
					theAddy=theBank->endAddress;		// Jump to the end
				}

				theBank->currentAddress=theAddy;
			}
		}

/*
		else if(theBank->currentAddress==theBank->targetAddress)		// Have we run through our entire sample or sample fragment?
		{
			if(theBank->loopOnce==true)							// Yes, and we should be done now.
			{
				theBank->audioFunction=AUDIO_IDLE;
				theBank->clockMode=CLK_NONE;
			}
			else
			{
				theBank->currentAddress=theBank->addressAfterLoop;		// We're at the end of the sample and we need to go back to the relative beginning of the sample.
			}
		}
		else
		{
			// theBank->currentAddress=(theBank->sampleIncrement+theAddy);	// "Increment" the sample address.  Note, this could be forward or backward and we must be sure not to skip the target address

			// @@@ We don't do this in overdub right now so probably overdub with widowed playback is busted.
			// @@@ I think we're playing one garbage sample looping this way, since we play the sample in the "endAddress" which is not filled in the record ISR.
			// Gotta check for absolute sample ends/beginnings to handle windowed playback, irritatingly
			// Will miss one sample when we roll around this way

			theAddy+=theBank->sampleIncrement;

			if(theAddy==theBank->endAddress)		// Just hit the absolute end?
			{
				theAddy=theBank->startAddress;		// Jump to the start
			}
			else if(theAddy==theBank->startAddress)	// Just hit the absolute start?
			{
				theAddy=theBank->endAddress;		// Jump to the end
			}

			theBank->currentAddress=theAddy;
		}
*/
		// Finish getting the byte from RAM.

		theBank->audioOutput=LATCH_INPUT;		// Get the byte from this address in RAM.
		PORTA|=(Om_RAM_OE);								// Tristate the RAM.
		LATCH_DDR=0xFF;						// Turn the data bus around (AVR's data port to outputs)

		// Bit rate reduction slows us down to about 10uS (sometimes a bit higher) when it's not 0 and we check with an IF statement as opposed to 8.25uS when it's off.
		// With the IF taken out, 8.7uS with no bit reduction, about 9.8uS when it's on.
		// Note, this is with 7-bit reduction.  Smaller numbers of bits give smaller delays.
		// So, keep the check.

		if(theBank->bitReduction)	// Low bit rate? The if statement saves us some time when the
		{
			theBank->audioOutput&=(0xFF<<theBank->bitReduction);		// Mask off however many bits we're supposed to.
		}

		// --------------------------------------------------
		// Now deal with outputting the byte on the DAC.
		// --------------------------------------------------
		// @@@ NOTE -- may want to somehow favor the ADD here.  Giving it's own IF doesn't help.

/*
		switch(outputFunction)		// How do we combine the audio outputs?  We can add them of course but also mess with them in artsy ways.
		{
			case OUTPUT_MULTIPLY:																				// NOTE -- multiply is really slow.  Fortunately, it sounds crappy so nobody uses it.
				sum0=((bankStates[BANK_0].audioOutput*bankStates[BANK_1].audioOutput)/64)+sdStreamOutput;			// Multiply the bank outputs, and divide them down to full scale DAC range (or so).  If this sounds too tame, we may want to make the divisor smaller and pin this to range as above.
				break;

			case OUTPUT_XOR:
				sum0=(bankStates[BANK_0].audioOutput^bankStates[BANK_1].audioOutput)+sdStreamOutput;				// Bitwise XOR the bank outputs, add in the SD card stream.
				break;

			case OUTPUT_AND:
				sum0=(bankStates[BANK_0].audioOutput&bankStates[BANK_1].audioOutput)+sdStreamOutput;				// Bitwise AND the bank outputs, add in the SD card stream.
				break;

			case OUTPUT_SUBTRACT:
				sum0=(bankStates[BANK_0].audioOutput-bankStates[BANK_1].audioOutput)+sdStreamOutput;				// Subtract bank1 from bank0 and add in the SD card output.
				break;

			case OUTPUT_ADD:
			default:
				sum0=bankStates[BANK_0].audioOutput+bankStates[BANK_1].audioOutput+sdStreamOutput;					// Sum everything that might be involved in our output waveform.
				break;
		}
*/

		// With the optimizer flag set to -O3 or -O2, the below is faster than a switch statement (about 8.0uS vs 8.25uS most loops, sometimes faster).  With -Os they turn out the same.  With -01 it's very slow.
		if(outputFunction==OUTPUT_ADD)
		{
			sum0=bankStates[BANK_0].audioOutput+bankStates[BANK_1].audioOutput+sdStreamOutput;				// Sum everything that might be involved in our output waveform.
		}
		else if(outputFunction==OUTPUT_SUBTRACT)
		{
			sum0=(bankStates[BANK_0].audioOutput-bankStates[BANK_1].audioOutput)+sdStreamOutput;			// Subtract bank1 from bank0 and add in the SD card output.
		}

		else if(outputFunction==OUTPUT_MULTIPLY)															// NOTE -- multiply is really slow.  Fortunately, it sounds crappy so nobody uses it.
		{
			sum0=((bankStates[BANK_0].audioOutput*bankStates[BANK_1].audioOutput)/64)+sdStreamOutput;		// Multiply the bank outputs, and divide them down to full scale DAC range (or so).  If this sounds too tame, we may want to make the divisor smaller and pin this to range as above.
		}
		else if(outputFunction==OUTPUT_XOR)
		{
			sum0=(bankStates[BANK_0].audioOutput^bankStates[BANK_1].audioOutput)+sdStreamOutput;			// Bitwise XOR the bank outputs, add in the SD card stream.
		}
		else	// OUTPUT_AND
		{
			sum0=(bankStates[BANK_0].audioOutput&bankStates[BANK_1].audioOutput)+sdStreamOutput;			// Bitwise AND the bank outputs, add in the SD card stream.
		}

		// Pin to range and spit it out.
		if(sum0>127)		// Pin high.
		{
			sum0=127;
		}
		else if(sum0<-128)		// Pin low.
		{
			sum0=-128;
		}

		dacOutput=(((signed char)sum0)^0x80);	// Cast the output back to 8 bits and then make it unsigned.

		if(dacOutput!=lastDacByte)	// Don't toggle PORTA pins if you don't have to (keep ADC noise down)
		{
			LATCH_DDR=0xFF;			// Turn the data bus around (AVR's data port to outputs)

			LATCH_PORT=dacOutput;		// Put the output on the output latch's input.
			PORTA|=(Om_DAC_LA);		// Strobe dac latch enable high -- this puts the output on the 373's output...
			PORTA&=~(Om_DAC_LA);	// ...And keeps it there.
		}

		lastDacByte=dacOutput;		// Flag this byte has having been spit out last time.
	}
}

static void RecordCallback(volatile BANK_STATE *theBank)
// See notes on PlayCallback above.
{
	unsigned long
		theAddy;	// Using a local nonvolatile variable allows the compiler to be smarter about the address resolution and not load a 32-bit number every time.

	LATCH_DDR=0xFF;							// Data bus to output -- we never need to read the RAM in this version of the ISR.
	theAddy=theBank->currentAddress;

	LATCH_PORT=theAddy;						// Put the LSB of the address on the latch.
	PORTA|=(Om_RAM_L_ADR_LA);				// Strobe it to the latch output...
	PORTA&=~(Om_RAM_L_ADR_LA);				// ...Keep it there.

	LATCH_PORT=(theAddy>>8);						// Put the middle byte of the address on the latch.
	PORTA|=(Om_RAM_H_ADR_LA);						// Strobe it to the latch output...
	PORTA&=~(Om_RAM_H_ADR_LA);						// ...Keep it there.

	PORTC=(0xA8|((unsigned char)(theAddy>>16)&0x07));	// Keep the switch OE high (hi z) (PC3), test pin high (PC7 used to time isrs), and the unused pins (PC4-6) low, and put the high addy bits on 0-2.

	LATCH_PORT=adcByte;							// Put the data to write on the RAM's input port

	theAddy+=theBank->sampleIncrement;			// Compute next address while the bus settles (will move forward or backward depending on the bank)
	theBank->currentAddress=theAddy;			// Store this as the current addy and also the end addresses
	theBank->endAddress=theAddy;				// Match ending address of the sample to the current memory address.
	theBank->adjustedEndAddress=theAddy;		// Match ending address of our user-trimmed loop (user has not done trimming yet).

	// @@@ if we increment this way, the end address will always be one memory location AFTER the last good sample; make sure that's what you want

	// Finish writing to RAM.
	PORTA&=~(Om_RAM_WE);				// Strobe Write Enable low.  This latches the data in.
	PORTA|=(Om_RAM_WE);					// Disbale writes.

	// Calculate bank overlap, little bit of time before we deal with the ADC for digital bus to settle.
	if(bankStates[BANK_0].endAddress>=bankStates[BANK_1].endAddress)	// Banks stepping on each other?  Note, this test will result in one overlapping RAM location.
	{
		theBank->audioFunction=AUDIO_IDLE;	// Stop recording on this channel.
		outOfRam=true;									// Signal mainline code that we're out of memory.
	}

	// Keep the ADC running
	if(!(ADCSRA&(1<<ADSC)))		// Last conversion done (note that once we start using different clock sources it's really possible to read this too often, so always check to make sure a conversion is done)
	{
		adcByte=(ADCH^0x80);	// Update our ADC conversion variable.  If we're really flying or using both interrupt sources we may use this value more than once.  Make it a signed char.
		ADCSRA |= (1<<ADSC);  	// Start the next ADC conversion (do it at the end of the callback so the ADC S/H acquires the sample after noisy RAM/DAC digital bus activity on PORTA -- this matters a lot)
	}
}

static void OverdubCallback(volatile BANK_STATE *theBank)
// WTPA has a destructive overdub.
// Read memory (as of now all audio functions end with the LATCH_DDR as an output so we don't need to set it at the beginning of this function)
// and do normal playback.  Then turn the bus around and put the ADC value PLUS the output value back into the RAM.  Then set the ADC running again.
// NOTE -- overdub stays within the boundaries of the first recorded sample.
{
	unsigned long
		theAddy;	// Using a local nonvolatile variable allows the compiler to be smarter about the address resolution and not load a 32-bit number every time.
	signed int
		sum0;		// Temporary variables for saturated adds, multiplies, other math.
	unsigned char
		dacOutput;		// What to put on the DAC

	if(theBank->sampleSkipCounter)		// Used for time division
	{
		theBank->sampleSkipCounter--;	// Don't play anything this time around
	}
	else
	{
		theBank->sampleSkipCounter=theBank->samplesToSkip;		// Reload number of samples to skip

		theAddy=theBank->currentAddress;		// Using a local nonvolatile variable allows the compiler to be smarter about the address resolution and not load a 32-bit number every time.

		LATCH_PORT=theAddy;							// Put the LSB of the address on the latch.
		PORTA|=(Om_RAM_L_ADR_LA);					// Strobe it to the latch output...
		PORTA&=~(Om_RAM_L_ADR_LA);					// ...Keep it there.

		LATCH_PORT=(theAddy>>8);					// Put the LSB of the address on the latch.
		PORTA|=(Om_RAM_H_ADR_LA);					// Strobe it to the latch output...
		PORTA&=~(Om_RAM_H_ADR_LA);					// ...Keep it there.

		PORTC=(0xA8|((unsigned char)(theAddy>>16)&0x07));			// Keep the switch OE high (hi z) (PC3), test pin high (PC7 used to time isrs), and the unused pins (PC4-6) low, and put the high addy bits on 0-2.  NOTE -- PC5 is card detect

		LATCH_DDR=0x00;								// Turn the data bus around (AVR's data port to inputs)
		PORTA&=~(Om_RAM_OE);						// RAM's IO pins to outputs.

		// Calculate new addy while data bus settles
// @@@ add granular bullshit in here
		if(theBank->currentAddress==theBank->targetAddress)		// Have we run through our entire sample or sample fragment?
		{
			if(theBank->loopOnce==true)									// Yes, and we should be done now.
			{
				theBank->audioFunction=AUDIO_IDLE;
				theBank->clockMode=CLK_NONE;
			}
			else
			{
				theBank->currentAddress=theBank->addressAfterLoop;		// We're at the end of the sample and we need to go back to the relative beginning of the sample.
			}
		}
		else
		{
			theBank->currentAddress=(theBank->sampleIncrement+theAddy);			// "Increment" the sample address.  Note, this could be forward or backward and we must be sure not to skip the target address
		}

		// Finish getting the byte from RAM.

		theBank->audioOutput=LATCH_INPUT;		// Get the byte from this address in RAM.
		PORTA|=(Om_RAM_OE);						// Tristate the RAM.
		LATCH_DDR=0xFF;							// Turn the data bus around (AVR's data port to outputs)

		if(theBank->bitReduction)	// Low bit rate? The if statement saves us some time when the
		{
			theBank->audioOutput&=(0xFF<<theBank->bitReduction);		// Mask off however many bits we're supposed to.
		}

		// --------------------------------------------------
		// Now deal with outputting the byte on the DAC.
		// --------------------------------------------------

		// With the optimizer flag set to -O3 or -O2, the below is faster than a switch statement (about 8.0uS vs 8.25uS most loops, sometimes faster).  With -Os they turn out the same.  With -01 it's very slow.
		if(outputFunction==OUTPUT_ADD)
		{
			sum0=bankStates[BANK_0].audioOutput+bankStates[BANK_1].audioOutput+sdStreamOutput;				// Sum everything that might be involved in our output waveform.
		}
		else if(outputFunction==OUTPUT_SUBTRACT)
		{
			sum0=(bankStates[BANK_0].audioOutput-bankStates[BANK_1].audioOutput)+sdStreamOutput;			// Subtract bank1 from bank0 and add in the SD card output.
		}

		else if(outputFunction==OUTPUT_MULTIPLY)															// NOTE -- multiply is really slow.  Fortunately, it sounds crappy so nobody uses it.
		{
			sum0=((bankStates[BANK_0].audioOutput*bankStates[BANK_1].audioOutput)/64)+sdStreamOutput;		// Multiply the bank outputs, and divide them down to full scale DAC range (or so).  If this sounds too tame, we may want to make the divisor smaller and pin this to range as above.
		}
		else if(outputFunction==OUTPUT_XOR)
		{
			sum0=(bankStates[BANK_0].audioOutput^bankStates[BANK_1].audioOutput)+sdStreamOutput;			// Bitwise XOR the bank outputs, add in the SD card stream.
		}
		else	// OUTPUT_AND
		{
			sum0=(bankStates[BANK_0].audioOutput&bankStates[BANK_1].audioOutput)+sdStreamOutput;			// Bitwise AND the bank outputs, add in the SD card stream.
		}

		// Pin to range and spit it out.
		if(sum0>127)		// Pin high.
		{
			sum0=127;
		}
		else if(sum0<-128)		// Pin low.
		{
			sum0=-128;
		}

		dacOutput=(((signed char)sum0)^0x80);	// Cast the output back to 8 bits and then make it unsigned.

		if(dacOutput!=lastDacByte)	// Don't toggle PORTA pins if you don't have to (keep ADC noise down)
		{
			LATCH_DDR=0xFF;			// Turn the data bus around (AVR's data port to outputs)

			LATCH_PORT=dacOutput;		// Put the output on the output latch's input.
			PORTA|=(Om_DAC_LA);		// Strobe dac latch enable high -- this puts the output on the 373's output...
			PORTA&=~(Om_DAC_LA);	// ...And keeps it there.
		}

		lastDacByte=dacOutput;		// Flag this byte has having been spit out last time.

		sum0=theBank->audioOutput+adcByte;	// Do saturated add mess.
		if(sum0>127)						// Saturate to top rail.
		{
			sum0=127;
		}
		else if(sum0<-128) 			// Saturate to bottom rail.
		{
			sum0=-128;
		}

		LATCH_PORT=(signed char)sum0;	// Now replace the data at this RAM location with the data summed from the ADC and output bytes.
		PORTA&=~(Om_RAM_WE);			// Strobe Write Enable low.  This latches the data in.
		PORTA|=(Om_RAM_WE);				// Disbale writes.

		// Keep the ADC running
		if(!(ADCSRA&(1<<ADSC)))		// Last conversion done (note that once we start using different clock sources it's really possible to read this too often, so always check to make sure a conversion is done)
		{
			adcByte=(ADCH^0x80);	// Update our ADC conversion variable.  If we're really flying or using both interrupt sources we may use this value more than once.  Make it a signed char.
			ADCSRA |= (1<<ADSC);  	// Start the next ADC conversion (do it at the end of the callback so the ADC S/H acquires the sample after noisy RAM/DAC digital bus activity on PORTA -- this matters a lot)
		}
	}
}

static void SawtoothCallback(volatile BANK_STATE *theBank)
// Just spit a sawtooth wave out the DAC.  We don't do anything with/to the bank here or the RAM
{
	static unsigned char
		sawtooth;		// Used for generating sawteeth.

	LATCH_DDR=0xFF;			// Turn the data bus around (AVR's data port to outputs)

	LATCH_PORT=sawtooth++;	// Put the output on the output latch's input.
	PORTA|=(Om_DAC_LA);		// Strobe dac latch enable high -- this puts the output on the 373's output...
	PORTA&=~(Om_DAC_LA);	// ...And keeps it there.
}

static void RealtimeCallback(volatile BANK_STATE *theBank)
// Does FX in realtime to the input -- just grabs an ADC byte, effects it, and spits it out.  No RAM usage.  Used to bit reduce, alias, or multiply an input in real time.
{
	signed int
		sum0;		// Temporary variables for saturated adds, multiplies, other math.
	unsigned char
		dacOutput;		// What to put on the DAC

	theBank->audioOutput=adcByte;		// Grab the value from the ADC, and put it back out.

	if(theBank->bitReduction)	// Low bit rate?
	{
		theBank->audioOutput&=(0xFF<<theBank->bitReduction);		// Mask off however many bits we're supposed to.
	}

	// --------------------------------------------------
	// Now deal with outputting the byte on the DAC.
	// --------------------------------------------------

	// With the optimizer flag set to -O3 or -O2, the below is faster than a switch statement (about 8.0uS vs 8.25uS most loops, sometimes faster).  With -Os they turn out the same.  With -01 it's very slow.
	if(outputFunction==OUTPUT_ADD)
	{
		sum0=bankStates[BANK_0].audioOutput+bankStates[BANK_1].audioOutput+sdStreamOutput;				// Sum everything that might be involved in our output waveform.
	}
	else if(outputFunction==OUTPUT_SUBTRACT)
	{
		sum0=(bankStates[BANK_0].audioOutput-bankStates[BANK_1].audioOutput)+sdStreamOutput;			// Subtract bank1 from bank0 and add in the SD card output.
	}

	else if(outputFunction==OUTPUT_MULTIPLY)															// NOTE -- multiply is really slow.  Fortunately, it sounds crappy so nobody uses it.
	{
		sum0=((bankStates[BANK_0].audioOutput*bankStates[BANK_1].audioOutput)/64)+sdStreamOutput;		// Multiply the bank outputs, and divide them down to full scale DAC range (or so).  If this sounds too tame, we may want to make the divisor smaller and pin this to range as above.
	}
	else if(outputFunction==OUTPUT_XOR)
	{
		sum0=(bankStates[BANK_0].audioOutput^bankStates[BANK_1].audioOutput)+sdStreamOutput;			// Bitwise XOR the bank outputs, add in the SD card stream.
	}
	else	// OUTPUT_AND
	{
		sum0=(bankStates[BANK_0].audioOutput&bankStates[BANK_1].audioOutput)+sdStreamOutput;			// Bitwise AND the bank outputs, add in the SD card stream.
	}

	// Pin to range and spit it out.
	if(sum0>127)		// Pin high.
	{
		sum0=127;
	}
	else if(sum0<-128)		// Pin low.
	{
		sum0=-128;
	}

	dacOutput=(((signed char)sum0)^0x80);	// Cast the output back to 8 bits and then make it unsigned.

	if(dacOutput!=lastDacByte)	// Don't toggle PORTA pins if you don't have to (keep ADC noise down)
	{
		LATCH_DDR=0xFF;			// Turn the data bus around (AVR's data port to outputs)

		LATCH_PORT=dacOutput;		// Put the output on the output latch's input.
		PORTA|=(Om_DAC_LA);		// Strobe dac latch enable high -- this puts the output on the 373's output...
		PORTA&=~(Om_DAC_LA);	// ...And keeps it there.
	}

	lastDacByte=dacOutput;		// Flag this byte has having been spit out last time.

	// Keep the ADC running
	if(!(ADCSRA&(1<<ADSC)))		// Last conversion done (note that once we start using different clock sources it's really possible to read this too often, so always check to make sure a conversion is done)
	{
		adcByte=(ADCH^0x80);	// Update our ADC conversion variable.  If we're really flying or using both interrupt sources we may use this value more than once.  Make it a signed char.
		ADCSRA |= (1<<ADSC);  	// Start the next ADC conversion (do it at the end of the callback so the ADC S/H acquires the sample after noisy RAM/DAC digital bus activity on PORTA -- this matters a lot)
	}
}

//-----------------------------------------------------------------------------
//-----------------------------------------------------------------------------
// Interrupt Vectors:
// These handle updating audio in the different banks (and the dumb LED intro)
//-----------------------------------------------------------------------------
//-----------------------------------------------------------------------------

ISR(TIMER1_CAPT_vect)
// The vector triggered by an external clock edge and associated with Bank0
{
//	PORTC|=Om_TEST_PIN;			// @@@ Used to time ISRs
	AudioCallback0(&bankStates[BANK_0]);
//	PORTC&=~Om_TEST_PIN;		// @@@ Used to time ISRs
}

ISR(PCINT2_vect)
// The vector triggered by a pin change and associated with Bank1
// It's on PC4
// Mon May 23 16:06:37 EDT 2011
// With new hardware (relaxation osc and pulse shaper) we removed the level check above.  The clock will be 0.5uS low pulses, so we should not ever get here unless we want to be here (IE, interrupts will be half as frequent).
// However, we will need to clear the pin-change interrupt flag, since it may get set again about the time this ISR is starting.  IE, we might get into the interrupt with a falling edge, the flag might clear, the edge might rise, and the flag will get set again.
// Since the pulses are so short (10 cycles) we can clear this flag at the end of this routine and be sure we're good to go.
// Fri Jun 24 11:20:40 EDT 2011
// They're more like 5uS now, but still plenty short
{
	AudioCallback1(&bankStates[BANK_1]);
	PCIFR|=(1<<PCIF2);                // Clear any pending interrupts hanging around from our rising edge
}

ISR(TIMER1_COMPA_vect)
// The bank0 internal timer vectors here on an interrupt.
{
	unsigned long
		jitterTemp;			// Used to calculate new jitter values.
	static unsigned int
		lastJitterValue;

	AudioCallback0(&bankStates[BANK_0]);

// @@@ fix jitter as much as possible.  Do you really need a long int for timerCyclesForNextNote?

	if(bankStates[BANK_0].jitterValue)				// Jitter on?	@@@ This math is wrong, or, more likely, this routine is too slow.  Once the jitterValue gets reasonably high we here the samples slow down -- Thu Aug  4 11:06:19 EDT 2011 Dumbass, it's probably the mod operation.
	{
		jitterTemp=bankStates[BANK_0].jitterValue*(unsigned long)bankStates[BANK_0].timerCyclesForNextNote;	// Scale the jitter value to our clock.
		jitterTemp=random31%(jitterTemp/JITTER_VALUE_MAX);									// Pick a random value between max and min possible jitter (when jitterValue == JITTER_VALUE_MAX this will be a random number from 0 to timerCyclesForNextNote).
		OCR1A+=(bankStates[BANK_0].timerCyclesForNextNote-jitterTemp)+lastJitterValue;		// To our OCR value we now add the normal time until the next interrupt MINUS some random number.  This gives us the jitter.  Then we add in the leftovers from the last jitter event, and this keeps our period constant. @@@ We can easily roll this register around for slow notes, but fuck it, this is about jitter, right?
		lastJitterValue=(unsigned int)jitterTemp;											// Store our jitter as an offset for next time; this keeps our period constant.
	}
	else
	{
		OCR1A+=bankStates[BANK_0].timerCyclesForNextNote;		// Set the interrupt register correctly for the next interrupt time.
	}
}

ISR(TIMER1_COMPB_vect)
// The interrupt associated with bank1 when it's using internal interrupts goes here.
{
	unsigned long
		jitterTemp;			// Used to calculate new jitter values.
	static unsigned int
		lastJitterValue;

	AudioCallback1(&bankStates[BANK_1]);

	if(bankStates[BANK_1].jitterValue)				// Jitter on?
	{
		jitterTemp=bankStates[BANK_1].jitterValue*(unsigned long)bankStates[BANK_1].timerCyclesForNextNote;	// Scale the jitter value to our clock.
		jitterTemp=random31%(jitterTemp/JITTER_VALUE_MAX);									// Pick a random value between max and min possible jitter (when jitterValue == JITTER_VALUE_MAX this will be a random number from 0 to timerCyclesForNextNote).
		OCR1B+=(bankStates[BANK_1].timerCyclesForNextNote-jitterTemp)+lastJitterValue;		// To our OCR value we now add the normal time until the next interrupt MINUS some random number.  This gives us the jitter.  Then we add in the leftovers from the last jitter event, and this keeps our period constant. @@@ We can easily roll this register around for slow notes, but fuck it, this is about jitter, right?
		lastJitterValue=(unsigned int)jitterTemp;											// Store our jitter as an offset for next time; this keeps our period constant.
	}
	else
	{
		OCR1B+=bankStates[BANK_1].timerCyclesForNextNote;		// Set the interrupt register correctly for the next interrupt time.
	}
}

ISR(TIMER2_COMPB_vect)
// This interrupt handles data in the SD buffer and doing what needs to be done with it.
// This includes direct playback from the SD card, writing SD data to the ram banks, and reading ram data.  All of these are at a fixed period.
// When writing/reading RAM, the bank in question should be locked against other RAM accesses.
{
	unsigned char
		theByte;
	signed int
		sum0;			// Temporary variables for saturated adds, multiplies, other math.
	unsigned char
		dacOutput;		// What to put on the DAC

	if(sdIsrState==SD_ISR_LOADING_RAM)	// Putting data from the SD buffer into a RAM bank?
	{
		if(sdRamSampleRemaining)	// Bytes remaining in the sample?
		{
			if(sdBytesInFifo)	// Anything currently in the FIFO?
			{
				theByte=sdFifo[sdFifoReadPointer];		// Grab data from the FIFO.

				sdFifoReadPointer++;					// Move to next spot in fifo
				if(sdFifoReadPointer>=SD_FIFO_SIZE)		// Handle wrapping around end of fifo
				{
					sdFifoReadPointer=0;
				}

				sdBytesInFifo--;				// One less byte in the FIFO
				sdRamSampleRemaining--;			// One less byte in the sample

				// Now put this byte into the RAM bank in the correct address.
				// @@@ NOTE -- we may be able to speed this up although sdRamAddress is not volatile

				LATCH_DDR=0xFF;								// Data bus to output -- we never need to read the RAM in this version of the ISR.
				LATCH_PORT=sdRamAddress;					// Put the LSB of the address on the latch.
				PORTA|=(Om_RAM_L_ADR_LA);					// Strobe it to the latch output...
				PORTA&=~(Om_RAM_L_ADR_LA);					// ...Keep it there.

				LATCH_PORT=(sdRamAddress>>8);				// Put the middle byte of the address on the latch.
				PORTA|=(Om_RAM_H_ADR_LA);					// Strobe it to the latch output...
				PORTA&=~(Om_RAM_H_ADR_LA);					// ...Keep it there.

				PORTC=(0xA8|((sdRamAddress>>16)&0x07));		// Keep the switch OE high (hi z) (PC3), test pin high (PC7 used to time isrs), and the unused pins (PC4-6) low, and put the high addy bits on 0-2.  PC5 is card detect
				LATCH_PORT=theByte;							// Put the data to write on the RAM's input port

				// Compute address while bus settles.
				if(sdBank0==true)		// Is this SD buffer being written to bank 0 (or bank 1)
				{
					sdRamAddress++;		// Next address is higher for bank 0...
				}
				else
				{
					sdRamAddress--;		// Next address is lower for bank 1.
				}

				// Finish writing to RAM.
				PORTA&=~(Om_RAM_WE);				// Strobe Write Enable low.  This latches the data in.
				PORTA|=(Om_RAM_WE);					// Disbale writes.

			}
		}
		else	// All sample bytes processed, end ISR and unlock the bank we were using.  Mark the current write address as the last address of the sample.
		{
			sdIsrState=SD_ISR_IDLE;		// ISR state to idle
			TCCR2B=0;					// Stop this timer
			TIMSK2&=~(1<<OCIE2B);		// Disable interrupt

			if(sdBank0==true)	// Unlock the bank for other RAM accesses, update final address
			{
				bankStates[BANK_0].isLocked=false;					// Unlock bank
				bankStates[BANK_0].endAddress=sdRamAddress;			// Match ending address of the sample to the current memory address.
				bankStates[BANK_0].adjustedEndAddress=sdRamAddress;	// Match ending address of our user-trimmed loop (user has not done trimming yet).
			}
			else
			{
				bankStates[BANK_1].isLocked=false;					// Unlock bank
				bankStates[BANK_1].endAddress=sdRamAddress;			// Match ending address of the sample to the current memory address.
				bankStates[BANK_1].adjustedEndAddress=sdRamAddress;	// Match ending address of our user-trimmed loop (user has not done trimming yet).
			}
		}
	}
	else if(sdIsrState==SD_ISR_READING_RAM)  // Putting data from RAM into the SD buffer?
	{
		// Reading the RAM, writing the SD -- Get bytes from RAM, put them in fifo.  When fifo fills, pause.  When the entire sample has been transferred to the FIFO, stop the ISR
		if(sdBytesInFifo<SD_FIFO_SIZE)	// Room in fifo?
		{
			if(sdRamSampleRemaining)	// Any sample left in RAM?
			{
				// Read SRAM (as of now all audio functions end with the LATCH_DDR as an output so we don't need to set it at the beginning of this function)
				LATCH_PORT=sdRamAddress;				// Put the LSB of the address on the latch.
				PORTA|=(Om_RAM_L_ADR_LA);				// Strobe it to the latch output...
				PORTA&=~(Om_RAM_L_ADR_LA);				// ...Keep it there.

				LATCH_PORT=(sdRamAddress>>8);			// Put the middle byte of the address on the latch.
				PORTA|=(Om_RAM_H_ADR_LA);				// Strobe it to the latch output...
				PORTA&=~(Om_RAM_H_ADR_LA);				// ...Keep it there.

				PORTC=(0xA8|((sdRamAddress>>16)&0x07));	// Keep the switch OE high (hi z) (PC3), test pin high (PC7 used to time isrs), and the unused pins (PC4-6) low, and put the high addy bits on 0-2.

				LATCH_DDR=0x00;						// Turn the data bus around (AVR's data port to inputs)
				PORTA&=~(Om_RAM_OE);				// RAM's IO pins to outputs.

				// Calculate new addy while data bus settles
				if(sdBank0==true)		// Is this SD buffer being read from bank 0 (or bank 1)
				{
					sdRamAddress++;		// Next address is higher for bank 0...
				}
				else
				{
					sdRamAddress--;		// Next address is lower for bank 1.
				}

				// Finish getting the byte from RAM.

				theByte=LATCH_INPUT;				// Get the byte from this address in RAM.
				PORTA|=(Om_RAM_OE);					// Tristate the RAM.
				LATCH_DDR=0xFF;						// Turn the data bus around (AVR's data port to outputs)

				// Now put this byte from RAM into the sd fifo


				sdFifo[sdFifoWritePointer]=theByte;	// Put our byte in the fifo.
				sdFifoWritePointer++;				// Move to next spot in fifo

				if(sdFifoWritePointer>=SD_FIFO_SIZE)				// Handle wrapping around end of fifo
				{
					sdFifoWritePointer=0;
				}

				sdBytesInFifo++;				// One more byte in the FIFO
				sdRamSampleRemaining--;		// One less byte in the sample

			}
			else	// No more bytes in the sample to be transferred.  Stop the ISR and unlock this RAM bank for the rest of the program
			{
				sdIsrState=SD_ISR_IDLE;		// ISR state to idle
				TCCR2B=0;					// Stop this timer
				TIMSK2&=~(1<<OCIE2B);		// Disable interrupt

				if(sdBank0==true)	// Unlock the bank for other RAM accesses
				{
					bankStates[BANK_0].isLocked=false;					// Unlock bank
				}
				else
				{
					bankStates[BANK_1].isLocked=false;					// Unlock bank
				}
			}
		}
	}
	else if(sdIsrState==SD_ISR_STREAMING_PLAYBACK)	// Streaming data directly from the SD buffer to the audio DAC?
	{
		if(sdRamSampleRemaining)	// Bytes remaining in the sample?
		{
			if(sdBytesInFifo)	// Anything currently in the FIFO?
			{
				theByte=sdFifo[sdFifoReadPointer];		// Grab data from the FIFO.

				sdFifoReadPointer++;					// Move to next spot in fifo
				if(sdFifoReadPointer>=SD_FIFO_SIZE)		// Handle wrapping around end of fifo
				{
					sdFifoReadPointer=0;
				}

				sdBytesInFifo--;				// One less byte in the FIFO
				sdRamSampleRemaining--;			// One less byte in the sample

				// Now spit the byte out the DAC.

// @@@ don't think we really need this copy, rather, we could just get sdStreamOutput from the FIFO above

				sdStreamOutput=theByte;		// Mark this byte as the one we want to go out in our DAC-updating routine

				// --------------------------------------------------
				// Now deal with outputting the byte on the DAC.
				// --------------------------------------------------

				// With the optimizer flag set to -O3 or -O2, the below is faster than a switch statement (about 8.0uS vs 8.25uS most loops, sometimes faster).  With -Os they turn out the same.  With -01 it's very slow.
				if(outputFunction==OUTPUT_ADD)
				{
					sum0=bankStates[BANK_0].audioOutput+bankStates[BANK_1].audioOutput+sdStreamOutput;				// Sum everything that might be involved in our output waveform.
				}
				else if(outputFunction==OUTPUT_SUBTRACT)
				{
					sum0=(bankStates[BANK_0].audioOutput-bankStates[BANK_1].audioOutput)+sdStreamOutput;			// Subtract bank1 from bank0 and add in the SD card output.
				}

				else if(outputFunction==OUTPUT_MULTIPLY)															// NOTE -- multiply is really slow.  Fortunately, it sounds crappy so nobody uses it.
				{
					sum0=((bankStates[BANK_0].audioOutput*bankStates[BANK_1].audioOutput)/64)+sdStreamOutput;		// Multiply the bank outputs, and divide them down to full scale DAC range (or so).  If this sounds too tame, we may want to make the divisor smaller and pin this to range as above.
				}
				else if(outputFunction==OUTPUT_XOR)
				{
					sum0=(bankStates[BANK_0].audioOutput^bankStates[BANK_1].audioOutput)+sdStreamOutput;			// Bitwise XOR the bank outputs, add in the SD card stream.
				}
				else	// OUTPUT_AND
				{
					sum0=(bankStates[BANK_0].audioOutput&bankStates[BANK_1].audioOutput)+sdStreamOutput;			// Bitwise AND the bank outputs, add in the SD card stream.
				}

				// Pin to range and spit it out.
				if(sum0>127)		// Pin high.
				{
					sum0=127;
				}
				else if(sum0<-128)		// Pin low.
				{
					sum0=-128;
				}

				dacOutput=(((signed char)sum0)^0x80);	// Cast the output back to 8 bits and then make it unsigned.

				if(dacOutput!=lastDacByte)	// Don't toggle PORTA pins if you don't have to (keep ADC noise down)
				{
					LATCH_DDR=0xFF;			// Turn the data bus around (AVR's data port to outputs)

					LATCH_PORT=dacOutput;		// Put the output on the output latch's input.
					PORTA|=(Om_DAC_LA);		// Strobe dac latch enable high -- this puts the output on the 373's output...
					PORTA&=~(Om_DAC_LA);	// ...And keeps it there.
				}

				lastDacByte=dacOutput;		// Flag this byte has having been spit out last time.
			}
		}
		else	// All sample bytes processed, end ISR and re-set the DAC to midscale
		{
			sdIsrState=SD_ISR_IDLE;		// ISR state to idle
			TCCR2B=0;					// Stop this timer
			TIMSK2&=~(1<<OCIE2B);		// Disable interrupt

			// Set this contribution to the DAC to midscale (this output source is now quiet)
			sdStreamOutput=0;
		}
	}
}

ISR(TIMER2_COMPA_vect)
// Serves exclusively to make our FABULOUS intro happen
// As far as the PWM goes, this should happen as often as possible.
{
	static unsigned char
		pwmCount;

	if(ledPwm>pwmCount)
	{
		LATCH_PORT=0xFF;	// LEDs go on.
	}
	else
	{
		LATCH_PORT=0x00;	// LEDs go off.
	}
	pwmCount++;
}

ISR(__vector_default)
{
    //  This means a bug happened.  Some interrupt that shouldn't have generated an interrupt went here, the default interrupt vector.
	//	printf("Buggy Interrupt Generated!  Flags = ");
	//  printf("*****put interrupt register values here****");
}

//-----------------------------------------------------------------------
//-----------------------------------------------------------------------
// State Machine Functions.
//-----------------------------------------------------------------------
//-----------------------------------------------------------------------

static void SetState(STATE_FUNC *newState)		// Sets the device to a new state, assumes it should begin at the first minor sub-state.
{
	State=newState;
	subState=SS_0;
}

//-----------------------------------------------------------------------
//-----------------------------------------------------------------------
// Local Software Clock stuff.
//-----------------------------------------------------------------------
//-----------------------------------------------------------------------

void HandleSoftclock(void)
// NOTE -- this is NOT an ISR.  That's so it doesn't mess with sampling.
// This does mean that we don't need to do atomic accesses to systemTicks, and we also can screw up our concept of time when we have a hang-ey loop.
{
	if(TIFR0&(1<<TOV0))		// Got a timer overflow flag?
	{
		TIFR0 |= (1<<TOV0);		// Reset the flag (by writing a one).
		systemTicks++;			// Increment the system ticks.
	}
}

static void InitSoftclock(void)
// Wed Dec  3 22:28:06 CST 2008
// I've changed the way the softclock works from the last rev.  It's no longer and interrupt based thing, so it doesn't potentially get in the way of the audio interrupts.
// Also, since hardware TIMR1 is needed for bigger and better things than keeping human-time, we're going to set the softclock timer up to poll a flag.
// This means we don't steal cycles from any other ISRs, but it also means that if we write dumb code (if we hang the main loop for more than a tick time)
// we might miss a systemTick.
// NOTE:  w/ TMR0 running at 1/256 prescale at 20MHz, our smallest time unit is 3.2768mSecs.
// NOTE:  w/ 16-bit system ticks we can only time 214 seconds at this rate.

// With /64 those times are 0.8192 mSecs and 53 seconds.  We did this for the sake of not missing encoder states.

{
	PRR&=~(1<<PRTIM0);	// Turn the TMR0 power on.
	TIMSK0=0x00;		// Disable all Timer 0 associated interrupts.
	TCCR0A=0;			// Normal Ports.
	TCNT0=0;			// Initialize the counter to 0.
	TIFR0=0xFF;			// Clear the interrupt flags by writing ones.
	systemTicks=0;
//	TCCR0B=0x04;		// Start the timer in Normal mode, prescaler at 1/256
	TCCR0B=0x03;		// Start the timer in Normal mode, prescaler at 1/64
}

//-----------------------------------------------------------------------
// LED functions:
//-----------------------------------------------------------------------

// Thu Apr  1 13:08:08 EDT 2010
// Changed blinking mechanisms to be smaller and blink fixed times, and also use fewer timer fcns

#define		BLINK_TIME			(SECOND/8)

static void BlinkLeds(unsigned int theMask)
// Sets up the mask of leds to blink and their blink rate.
// NOTE:  All leds made to blink will blink synchronously at the rate last set.  This saves us from having 8 separate software clocks.
// NOTE:  When an LED is told to stop blinking it will revert to OFF, even if the LED was ON when we told it to blink.  I can live with this.
{
	unsigned char
		i;

	for(i=0; i<NUM_LEDS; i++)		// Go through all the LEDs...
	{
		if(ledBlinkMask&(1<<i))		// ...and if a LED was supposed to be blinking...
		{
			ledOnOffMask&=~(1<<i);		// ...turn it off.  This makes sure any blinking LEDs don't stop their blinks in the 'on' state.
		}
	}

	ledBlinkMask=theMask;				// Now assign new leds to blink.
	SetTimer(TIMER_BLINK,BLINK_TIME);	// And the time that they will all blink to.
}

static void StopBlinking(void)
// Stops all blinking LEDs.
{
	BlinkLeds(0);		// Durrrr.....
}

static void KillLeds(void)
// Turns off all LEDs immediately.
{
	ledOnOffMask=0;
	BlinkLeds(0);		// Durrrr.....
}

static void WriteLedLatch(unsigned char theMask)
// Take the current on/off LED mask and put it onto the LED output latch.
// This and the switch handler are the only mainline (non IRQ) code that messes with the databus.
{
	unsigned char
		sreg;

	sreg=SREG;	// Store global interrupt state
	cli();		// Clear global interrupts (so we don't get an audio interrupt while messing with OE and WE)

	LATCH_PORT=theMask;				// Put passed data onto bus.
	LATCH_DDR=0xFF;					// Make sure the bus is an output.
	PORTD|=(Om_LED_LA);				// Strobe it to the latch output...
	PORTD&=~(Om_LED_LA);			// ...Keep it there.

	SREG=sreg;						// Restore interrupts.
}

static void HandleLeds(void)
// Runs in the main loop updating the state of the LEDs.  Only messes with the databus when there's something to change.
{
	unsigned char
		i;
	static bool
		toggle;				// Flip flop for blinking.
	static unsigned char
		lastLedMask=0;		// Used to see if LEDs have been changed during a given loop.

	if(ledBlinkMask&&CheckTimer(TIMER_BLINK))		// Are we blinking and is it time to toggle?
	{
		for(i=0; i<NUM_LEDS; i++)	// Which LEDs are we blinking?
		{
			if(ledBlinkMask&(1<<i))
			{
				if(toggle)			// Flip flop the LEDs we're blinking every time the timer runs out.
				{
					ledOnOffMask|=(1<<i);
				}
				else
				{
					ledOnOffMask&=~(1<<i);
				}
			}
		}

		toggle=(!toggle);						// flip the sign of the led for next time.
		SetTimer(TIMER_BLINK,BLINK_TIME);		// And wait until next time.
		WriteLedLatch(ledOnOffMask);			// Send the LED value to the latch.
	}
	else if(lastLedMask!=ledOnOffMask) // If we're not blinking, but our LEDs have been instructed to change...
	{
		WriteLedLatch(ledOnOffMask);	// ...send the LED value to the latch.
		lastLedMask=ledOnOffMask;		// And mark it as sent.
	}
}

static void InitLeds(void)
{
	ledOnOffMask=0;
	ledBlinkMask=0;
	WriteLedLatch(0);	// ...send the LED value to the latch.
}

//-----------------------------------------------------------------------
//-----------------------------------------------------------------------
// Switch functions:
//-----------------------------------------------------------------------
//-----------------------------------------------------------------------

static void InitSwitches(void)
{
	SetTimer(TIMER_DEBOUNCE,(SECOND/32));	// Start debounce counter.

	DDRC&=~Im_CARD_DETECT;	// Card detect pin to input.
	PORTC|=Im_CARD_DETECT;	// Pull it up.

}

static void HandleSwitches(void)
// Read input pins, debounce, make keypresses positive-true, and flag newly-appeared keys.
// Make sure we've allowed enough time to turn the bus around.  The old RAM took a couple cycles before its data was valid, and this does too.
{
	static unsigned char
		lastKeyState;
	unsigned char
		sreg;

	if(CheckTimer(TIMER_DEBOUNCE))	// Time to read switches?
	{
		// Pause interrupts, monkey with datalatch, get switch data, resume interrupts.
		sreg=SREG;
		cli();						// Store sreg, pause interrupts.
		LATCH_PORT=0xFF;			// @@@ Pullups here seem to make the bus turn around less of a mess.
		LATCH_DDR=0x00;				// Turn the data bus around (AVR's data port to inputs)
		PORTC&=~Om_SWITCH_LA;		// Enable switch latch outputs (OE Low)
		asm volatile("nop"::);		// Needed for bus turnaround time (2 nops)
		asm volatile("nop"::);
		keyState=~LATCH_INPUT;		// Grab new keystate and invert so that pressed keys are 1s
		PORTC|=Om_SWITCH_LA;		// Tristate switch latch outputs (OE high)
		LATCH_DDR=0xFF;				// Turn the data bus rightside up (AVR gots the bus)
		SREG=sreg;					// Stop tying up interrupts

		if(!(PINC&Im_CARD_DETECT))	// Handle SD card switch (has a real hardware pin)
		{
			cardDetect=true;
		}
		else
		{
			cardDetect=false;
		}

		SetTimer(TIMER_DEBOUNCE,(SECOND/32));	// Reset timer (allow time for bus to turn around)
	}

	newKeys=((keyState^lastKeyState)&(keyState));		// Flag the keys which have been pressed since the last test.
	keysHeld=keyState&(~newKeys);						// Separate out keys which are NOT newly pressed, but have been held for more than one debounce loop.
	lastKeyState=keyState;								// And store this keystate as old news.
}

//-----------------------------------------------------------------------
//-----------------------------------------------------------------------
// Encoder functions:
//-----------------------------------------------------------------------
//-----------------------------------------------------------------------
// The encoders I set this up with are 24 pulses per revolution.
// They are Bourns 652-PEC124230F-N0024, from Mouser.
// From the DS:  5mSec max bounce at 15RPM (waaay faster than we'll go) with "standard noise reduction filters" (which we ain't got, whatever that means).
// This encoder (like most others) puts out 2 bit Gray code (where only one switch changes at a time) and its sequence is 00, 01, 11, 10 then back around.

// Thu Sep  2 15:04:47 EDT 2010
// OK.  More monkeying with reading the encoder shows us that a "pulse" is actually a transition of 4 states -- the encoder returns to 1,1 at a detent.
// This is good (it means more resolution -- there are 4*24 readable transitions per revolution) but it also means we have to read it faster.  OR we could read it coarsely, or whatever.
// Did this -- the encoder is really sensitive.  We still either miss reads or are getting switch bounce trouble.

// Thu Sep  2 16:39:43 EDT 2010 -- Added hardware filter from the panasonic datasheet.  Works a dream.  Still probably some tinkering to do, but it's pretty close.

// Encoder bit masks (dependent on port position)
#define	ENC_POS_A	0x00
#define	ENC_POS_B	0x40
#define	ENC_POS_C	0xC0
#define	ENC_POS_D	0x80

static void InitEncoder(void)
{
	encoderState=(PINA&Im_ENCODER_PINS);	// Initial encoder state read from pins directly.
	encoderValue=0;							// zero our relative position.
	newEncoder=false;
	encoderCw=false;
	encoderCcw=false;
}

static void HandleEncoder(void)
// Fri Jun 24 11:29:53 EDT 2011
// Steps backwards from earlier prototype for some reason
{
	static unsigned char
		lastEncoderState=0;
	static unsigned int
		lastEncTime=0;

	newEncoder=false;	// Clear variables which indicate changes in encoder readings
	encoderCw=false;
	encoderCcw=false;

	if(systemTicks!=lastEncTime)		// Read encoder once every system tick (around 0.8 mSecs)
	{
		lastEncTime=systemTicks;					// update last read time.

		encoderState=(PINA&Im_ENCODER_PINS);		// Read encoder state from pins directly.

		if(encoderState!=lastEncoderState)	// Has the encoder value changed?  If so, update the value if the change looks valid.
		{
			if(encoderState==ENC_POS_A)
			{
				if(lastEncoderState==ENC_POS_D)
				{
//					encoderValue++;
					encoderValue--;
					encoderCcw=true;
					newEncoder=true;
				}
				else if(lastEncoderState==ENC_POS_B)
				{
//					encoderValue--;
					encoderValue++;
					encoderCw=true;
					newEncoder=true;
				}
			}
			else if(encoderState==ENC_POS_B)
			{
				if(lastEncoderState==ENC_POS_A)
				{
//					encoderValue++;
					encoderValue--;
					encoderCcw=true;
					newEncoder=true;
				}
				else if(lastEncoderState==ENC_POS_C)
				{
//					encoderValue--;
					encoderValue++;
					encoderCw=true;
					newEncoder=true;
				}
			}
			else if(encoderState==ENC_POS_C)
			{
				if(lastEncoderState==ENC_POS_B)
				{
//					encoderValue++;
					encoderValue--;
					encoderCcw=true;
					newEncoder=true;
				}
				else if(lastEncoderState==ENC_POS_D)
				{
//					encoderValue--;
					encoderValue++;
					encoderCw=true;
					newEncoder=true;
				}
			}
			else if(encoderState==ENC_POS_D)
			{
				if(lastEncoderState==ENC_POS_C)
				{
//					encoderValue++;
					encoderValue--;
					encoderCcw=true;
					newEncoder=true;
				}
				else if(lastEncoderState==ENC_POS_A)
				{
//					encoderValue--;
					encoderValue++;
					encoderCw=true;
					newEncoder=true;
				}
			}

			lastEncoderState=encoderState;		// Keep this state around to evaluate the next one.
		}
	}
}

//-----------------------------------------------------------------------
//-----------------------------------------------------------------------
// A/D Control Functions:
//-----------------------------------------------------------------------
//-----------------------------------------------------------------------
// WTPA2 uses only one analog input (ADC0).  It's used to sample the audio input.  In old versions there were others that handled overdub and control pot reading, etc.
// The best resolution we can get from this hardware is 10 bits, +/- 2 lsbs.
// The max sampling rate we can pull at full resolution is 15kHz.  We always use the ADC single ended (so far) as the datasheet says that the ADC isn't guaranteed to
// work in differential mode with the PDIP package.  A conversion takes 13 ADC clocks normally, or 25 for the first conversion after the channel is selected.
// The datasheet is unclear how much resolution is lost above 15kHz.  Guess we'll find out!
// NOTE:  Since the RAM can only store 8 bits per sample, we're only using 8 bits of the conversion data.  Can't imagine those last two bits are going to be worth much at these sample rates anyhoo.

/*
static void UnInitAdc(void)
{
	ADCSRA&=~(1<<ADEN);		// Disable ADC.
	PRR|=(1<<PRADC);		// Power down the ADC.
}
*/

static void InitAdc(void)
// Note, we don't set up the Adc to trigger on anything right away.
{
	PRR&=~(1<<PRADC);		// Turn the ADC power on (clear the bit to power on).
	ADMUX = 0x60; 			// 0110 0000.  AVCC is the reference (w/ ext cap), left justify the result, start with ADC0 as the channel.  The ADC always wants to see a cap at AREF if the internal references or VCC are used.
	DIDR0 = 0x01;			// Disable the digital input for ADC0.
	ADCSRA = 0x95;			// 1001 0101 (prescaler to 32 = ~48kHz sample rate, (64 = 24kHz).  Enable the ADC, no autotrigger or interrupts. (For ex: at 8MHz sysclk and 1/64, ADC clock = 125kHz, normal conversion ~= 10kHz (13 samples per conversion).  According to the datasheet, to get max resolution from the converter, the ADC clock must be between 50 and 200kHz.)
//	ADCSRA = 0x96;			// 1001 0110 (prescaler to 64 = ~24kHz sample rate, (32 = 48kHz).  Enable the ADC, no autotrigger or interrupts. (For ex: at 8MHz sysclk and 1/64, ADC clock = 125kHz, normal conversion ~= 10kHz (13 samples per conversion).  According to the datasheet, to get max resolution from the converter, the ADC clock must be between 50 and 200kHz.)
	ADCSRA |= (1<<ADSC);  	// Start the first conversion to initialize the ADC.
	// ADCSRB controls auto-triggering, which we aren't using right now.
}

//-----------------------------------------------------------------------
// RAM / DAC functions:
//-----------------------------------------------------------------------

// Fri Jun 17 19:11:18 EDT 2011
// As of WTPA2 these are all inlined where they need to go.  The notes below are for posterity

// Will be totally different than the oldschool serial biz.....
// Should probably all be inlined in the ISR.
// Just so you remember, Parallel SRAM pretty much always works like this:

// The chip is always enabled (CS is always low).  The other two control pins are active low also -- they are Write Enable and Output Enable.
// When WE is low, the value on the DATA pins is latched into the address on the ADDRESS pins.  Asserting WE will also override OE and make the RAM's DATA Pins go high impedance.
// When WE is high, the byte stored at the ADDRESS on pins A0-A18 is latched out on the DATA pins, assuming OE is low.
// If OE is high, the DATA port will be high impedance no matter what.
// The ADDRESS pins can always be outputs as far as the MCU is concerned.

// A typical write might look like:
// 1.)  OE and WE are high.
// 2.)  The address is set and the data latches on the MCU are made into outputs. The correct values of Data and Address are set on the corresponding pins.
// 3.)  WE is brought low and the data is latched in.
// 4.)  WE is brought high.  The address and data lines can now be changed without messing up data on the RAM chip.

// A typical read might look like this:
// 1.)  OE and WE are high.
// 2.)  The address is set correctly and the DATA PORT on the MCU is made high impedance.
// 3.)  OE is brought low, and the data to be read shows up on the DATA lines.
// 4.)  The MCU reads the DATA lines.
// 5.)  OE can be brought high again or left low -- it only needs to change if we're going to write to the chip.

// On 373 Parallel Latches:
// These guys are pretty simple.  In this circuit, their OE is tied low (enabled).
// While LE (Latch Enable) is High, the Latch is transparent from input port to output port.
// When LE is brought low, the current state of the inputs will be latched, and the outputs will that hold value while LE remains low (there's a little delay but it isn't relevant for us).
// So, we will will probably just leave LE low most of the time on the latches and strobe it high when we want to update that particular latch.



//-----------------------------------------------------------------------
//-----------------------------------------------------------------------
// General Sampler/ISR Functions:
//-----------------------------------------------------------------------
//-----------------------------------------------------------------------
// We've changed these to use both OCR1x interrupts and the "normal" waveform generation mode (from the single OCR1A and CTC mode).
// 	This allows us to generate different pitches for the two banks using TIMER1.  We do this by reading the counter and adding the number of cycles until the next interrupt to the OCR every time
// 	that interrupt occurs.  The OCR value will keep rolling like this, the timer will never be reset to zero, and we will be able to use as many OCRs as are available to generate different pitches.
//  On the mega164p this is two, there are newer devices with more 16 bit timers, and more interrupts per timer.

// Tue Aug 23 18:25:06 EDT 2011
// Updated these functions to clear the sdUsingBank(x) flags when these are called so the interrupts dont do any sd related stuff.  Necessary since we can call one of these during SD streaming playback.

// Thu Nov 24 19:22:24 CST 2011
// Updated to account for locking banks (removed above).  Necessary now because we can be screwing with RAM via SD stuff as well as play/rec.  Also the SD has its own ISR now which makes more sense.

static void SetSampleClock(unsigned char theBank, unsigned char theClock, unsigned int theRate)
// This code is common to all the requests to start different audio modes (record, playback, overdub, etc) and sets the correct clock source for a given bank.
// Timer interrupts should be disabled when you call this!
{
	bankStates[theBank].clockMode=theClock;	// What type of interrupt should trigger this sample bank?  Put this in the bank variables so other functions can see.

	if(theClock==CLK_INTERNAL)				// The internally counted clock is usually associated with MIDI-controlled sampling (output capture on timer 1)
	{
		bankStates[theBank].timerCyclesForNextNote=theRate;	// No matter what bank we're in, keep this value so we can use it to keep setting interrupt times.

		if(theBank==BANK_0)		// Bank 0 is associated with OCR1A
		{
			OCR1A=(theRate+TCNT1);	// Find spot for next interrupt to give the right pitch.
			TIFR1|=(1<<OCF1A);		// Clear the interrupt flag.
			TIMSK1|=(1<<OCIE1A);	// Enable the compare match interrupt.
			TCCR1B=0x01;			// Make sure TIMER1 is going, and in normal mode.
		}
		else					// Bank 1 is associated with OCR1B
		{
			OCR1B=(theRate+TCNT1);	// Find spot for next interrupt to give the right pitch.
			TIFR1|=(1<<OCF1B);		// Clear the interrupt flag.
			TIMSK1|=(1<<OCIE1B);	// Enable the compare match interrupt.
			TCCR1B=0x01;			// Make sure TIMER1 is going, and in normal mode.
		}
	}
	else if(theClock==CLK_EXTERNAL)	// External clock.
	{
		if(theBank==BANK_0)		// Bank 0 is based on Input Capture interrupts (rising edge from the sample clock oscillator)
		{
			TCCR1B|=(1<<ICES1);		// Trigger on a rising edge.
			TIFR1|=(1<<ICF1);		// Clear Input Capture interrupt flag.
			TIMSK1|=(1<<ICIE1);		// Enable Input Capture Interrupt (yo, son, I thought I was the Icy One?)
		}
		else					// Bank1 is based on PC4's pin change interrupt (PCINT20, which is associated with PC interrupt 2)
		{
			PCIFR|=(1<<PCIF2);		// Clear any pending interrupts hanging around.
			PCICR=(1<<PCIE2);		// Enable the pin change interrupt for PORTC.
			PCMSK2=0x10;			// PORTC pin 4 generates interrupt
		}
	}
}

/*
static void SetSampleDirection(unsigned char theBank)
// So, WTPA2 can play samples forwards and backwards, and the different banks in RAM can grow up or down depending on where they are in the array.
// Further, when the sample is edited, we can move the "end" of the sample in front of the beginning and when we do that, the direction of playback should reverse.
// In order to keep this straight we wrote this function.
// Thu Nov  7 16:21:42 EST 2013
// As of right now this assumes that samples only move forward one sample at a time during normal playback.  We can fix this by returning a bool for direction if needed and worry about magnitude elsewhere.
// NOTE -- the case for BANK_0 and BANK_1 are exactly the same right now...
// Fri Nov  8 10:33:28 EST 2013
// Ought to make sure we pause interrupts when we're messing with this stuff
{
	if(theBank==BANK_0)		// Bank_0 starts at address zero and normally plays forward by incrementing
	{
		if(bankStates[theBank].backwardsPlayback==true)
		{
			if(bankStates[theBank].adjustedStartAddress>bankStates[theBank].adjustedEndAddress)
			{
				bankStates[theBank].sampleIncrement=1;
			}
			else
			{
				bankStates[theBank].sampleIncrement=-1;
			}
		}
		else
		{
			if(bankStates[theBank].adjustedStartAddress>bankStates[theBank].adjustedEndAddress)
			{
				bankStates[theBank].sampleIncrement=-1;
			}
			else
			{
				bankStates[theBank].sampleIncrement=1;
			}
		}
	}
	else					// Bank_1 starts at the end of RAM and normally plays forward by decrementing
	{
		if(bankStates[theBank].backwardsPlayback==true)
		{
			if(bankStates[theBank].adjustedStartAddress>bankStates[theBank].adjustedEndAddress)
			{
				bankStates[theBank].sampleIncrement=1;
			}
			else
			{
				bankStates[theBank].sampleIncrement=-1;
			}
		}
		else
		{
			if(bankStates[theBank].adjustedStartAddress>bankStates[theBank].adjustedEndAddress)
			{
				bankStates[theBank].sampleIncrement=-1;
			}
			else
			{
				bankStates[theBank].sampleIncrement=1;
			}
		}
	}
}
*/

static void StartRecording(unsigned char theBank, unsigned char theClock, unsigned int theRate)
// Set the memory pointer to the start of RAM, set up the clock source, set the interrupt to the recording handler, and enable interrupts.
// If we're using the internal clock, set the rate.
// Sat Apr 11 13:49:31 CDT 2009  --  ?
// Thu Nov 24 19:22:05 CST 2011  --  Still allow play/rec to step on each other, but don't allow them to abort SD RAM access since that could mess up files saved on the SD.
// Tue Nov  5 17:34:22 EST 2013
// Updated for new callback based ISR
{

	unsigned char
		sreg;

	if((bankStates[theBank].isLocked==false)||((sdIsrState!=SD_ISR_LOADING_RAM)&&(sdIsrState!=SD_ISR_READING_RAM)))		// Check whether the bank is locked but ONLY BY SD FUNCTIONS.  Normal RAM play/rec functions can step on each other.
	{
		sreg=SREG;	// Store global interrupt state.
		cli();		// Disable interrupts while we muck with the settings.

		bankStates[theBank].audioFunction=AUDIO_RECORD;							// What should we be doing when we get into the ISR?

		bankStates[theBank].currentAddress=bankStates[theBank].startAddress;		// Point to the beginning of our allocated sampling area.
		bankStates[theBank].endAddress=bankStates[theBank].startAddress;			// And indicate that our sample is now 0 samples big.
		bankStates[theBank].adjustedStartAddress=bankStates[theBank].startAddress;	// No user trimming yet
		bankStates[theBank].adjustedEndAddress=bankStates[theBank].startAddress;	// "
		bankStates[theBank].sampleWindowOffset=0;									// "

		bankStates[theBank].audioOutput=0;	// When we're recording we are not putting anything on the output

		if(theBank==BANK_0)					// Move by ONE sample per clock, direction based on the bank
		{
			AudioCallback0=RecordCallback;
			bankStates[theBank].sampleIncrement=1;
		}
		else
		{
			AudioCallback1=RecordCallback;
			bankStates[theBank].sampleIncrement=-1;
		}
		outOfRam=false;						// Plenty of ram left...

		SetSampleClock(theBank,theClock,theRate);	// Set the appropriate clock source for this audio function.
		bankStates[theBank].isLocked=true;			// Let program know we're using this RAM bank right now.

		SREG=sreg;		// Restore interrupts.

		// Throw out the results of an old conversion since it could be very old (unless it's already going)
		if(!(ADCSRA&(1<<ADSC)))			// Last conversion done (note that once we start using different clock sources it's really possible to read this too often, so always check to make sure a conversion is done)
		{
			adcByte=(ADCH^0x80);		// Update our ADC conversion variable.  If we're really flying or using both interrupt sources we may use this value more than once.  Make it a signed char.
			ADCSRA |= (1<<ADSC);  		// Start the next conversion.
		}
	}
}

static void StartPlayback(unsigned char theBank, unsigned char theClock, unsigned int theRate)
// Point to the beginning of the sample, select the clock source, and get the interrupts going.
// Set the clock rate if we're using the internal clock.
{
	unsigned char
		sreg;

	if((bankStates[theBank].isLocked==false)||((sdIsrState!=SD_ISR_LOADING_RAM)&&(sdIsrState!=SD_ISR_READING_RAM)))		// Check whether the bank is locked but ONLY BY SD FUNCTIONS.  Normal RAM play/rec functions can step on each other.
	{
		sreg=SREG;	// Store global interrupt state.
		cli();		// Disable interrupts while we muck with the settings.

		bankStates[theBank].audioFunction=AUDIO_PLAYBACK;						// What should we be doing when we get into the ISR?

		if(bankStates[theBank].backwardsPlayback)		// Playing backwards?
		{
			bankStates[theBank].currentAddress=bankStates[theBank].adjustedEndAddress;		// Point to the "beginning" of our sample.
			bankStates[theBank].targetAddress=bankStates[theBank].adjustedStartAddress;		// Jump when you get to this memory address
			bankStates[theBank].addressAfterLoop=bankStates[theBank].adjustedEndAddress;	// And jump to this location

		}
		else																				// Playing forwards.
		{
			bankStates[theBank].currentAddress=bankStates[theBank].adjustedStartAddress;	// Point to the beginning of our sample.
			bankStates[theBank].targetAddress=bankStates[theBank].adjustedEndAddress;		// Jump when you get to this memory address
			bankStates[theBank].addressAfterLoop=bankStates[theBank].adjustedStartAddress;	// And jump to this location
		}

		if(theBank==BANK_0)		// Set all the ISR variables appropriately to the bank
		{
			AudioCallback0=PlayCallback;
		}
		else
		{
			AudioCallback1=PlayCallback;
		}

		UpdateAdjustedSampleAddresses(theBank);		// Make sure our sample is playing in the right direction, etc etc

		SetSampleClock(theBank,theClock,theRate);	// Set the appropriate clock source for this audio function.
		bankStates[theBank].isLocked=true;			// Let program know we're using this RAM bank right now.
		SREG=sreg;		// Restore interrupts.
	}
}

static void ContinuePlayback(unsigned char theBank, unsigned char theClock, unsigned int theRate)
// Sets the clock source and ISR appropriately to do playback, but does not move the RAM pointer.
// Used if we pause playback and want to continue where we left off, or stop overdubbing and jump right back into playback.
{
	unsigned char
		sreg;

	if((bankStates[theBank].isLocked==false)||((sdIsrState!=SD_ISR_LOADING_RAM)&&(sdIsrState!=SD_ISR_READING_RAM)))		// Check whether the bank is locked but ONLY BY SD FUNCTIONS.  Normal RAM play/rec functions can step on each other.
	{
		sreg=SREG;	// Store global interrupt state.
		cli();		// Disable interrupts while we muck with the settings.

		bankStates[theBank].audioFunction=AUDIO_PLAYBACK;	// What should we be doing when we get into the ISR?
		SetSampleClock(theBank,theClock,theRate);			// Set the appropriate clock source for this audio function.

		bankStates[theBank].isLocked=true;			// Let program know we're using this RAM bank right now.

		if(theBank==BANK_0)							// We can get to "continue" from "overdub" so make sure we have the correct callback
		{
			AudioCallback0=PlayCallback;
		}
		else
		{
			AudioCallback1=PlayCallback;
		}

		SREG=sreg;		// Restore interrupts.
	}
}

static void StartOverdub(unsigned char theBank, unsigned char theClock, unsigned int theRate)
// Begin recording to ram at the current RAM address.
// Continue playing back from that address, too.
{
	unsigned char
		sreg;

	if((bankStates[theBank].isLocked==false)||((sdIsrState!=SD_ISR_LOADING_RAM)&&(sdIsrState!=SD_ISR_READING_RAM)))		// Check whether the bank is locked but ONLY BY SD FUNCTIONS.  Normal RAM play/rec functions can step on each other.
	{
		sreg=SREG;	// Store global interrupt state.
		cli();		// Disable interrupts while we muck with the settings.

		if(theBank==BANK_0)							// We can get to "continue" from "overdub" so make sure we have the correct callback
		{
			AudioCallback0=OverdubCallback;
		}
		else
		{
			AudioCallback1=OverdubCallback;
		}

		bankStates[theBank].audioFunction=AUDIO_OVERDUB;	// What should we be doing when we get into the ISR?
		SetSampleClock(theBank,theClock,theRate);			// Set the appropriate clock source for this audio function.

		bankStates[theBank].isLocked=true;			// Let program know we're using this RAM bank right now.
		SREG=sreg;		// Restore interrupts.

		// Throw out the results of an old conversion since it could be very old (unless it's already going)
		if(!(ADCSRA&(1<<ADSC)))			// Last conversion done (note that once we start using different clock sources it's really possible to read this too often, so always check to make sure a conversion is done)
		{
			adcByte=(ADCH^0x80);		// Update our ADC conversion variable.  If we're really flying or using both interrupt sources we may use this value more than once.  Make it a signed char.
			ADCSRA |= (1<<ADSC);  		// Start the next conversion.
		}
	}
}

static void StartRealtime(unsigned char theBank, unsigned char theClock, unsigned int theRate)
// Begins processing audio in realtime on the passed channel using the passed clock source.
// Thu Nov 24 19:40:21 CST 2011
// OK to do realtime even when banks are locked since we don't use the RAM
{
	unsigned char
		sreg;

	sreg=SREG;	// Store global interrupt state.
	cli();		// Disable interrupts while we muck with the settings.

	bankStates[theBank].audioFunction=AUDIO_REALTIME;	// What should we be doing when we get into the ISR?
	SetSampleClock(theBank,theClock,theRate);			// Set the appropriate clock source for this audio function.

	if(theBank==BANK_0)							// We can get to "continue" from "overdub" so make sure we have the correct callback
	{
		AudioCallback0=RealtimeCallback;
	}
	else
	{
		AudioCallback1=RealtimeCallback;
	}

	SREG=sreg;		// Restore interrupts.

	if(!(ADCSRA&(1<<ADSC)))			// Last conversion done (note that once we start using different clock sources it's really possible to read this too often, so always check to make sure a conversion is done)
	{
		adcByte=(ADCH^0x80);		// Update our ADC conversion variable.  If we're really flying or using both interrupt sources we may use this value more than once.  Make it a signed char.
		ADCSRA |= (1<<ADSC);  		// Start the next conversion.
	}
}

/*
static void UnInitSampleClock(void)
{
	PRR|=(1<<PRTIM1);	// Turn the TMR1 power off.
}
*/

static void InitSampleClock(void)
// Get TMR1 ready to generate some equal temperament, or as equal as I can do (for MIDI)
// Or just turn it on so we can use the Input Capture pin to generate interrupts for the external clock (for the loop sampler).
{
	PRR&=~(1<<PRTIM1);	// Turn the TMR1 power on.
	TIMSK1=0x00;		// Disable all Timer 1 associated interrupts.
	OCR1A=65535;		// Set the compare register arbitrarily
	OCR1B=65535;		// Set the compare register arbitrarily
	TCCR1A=0;			// Normal Ports.
	TCCR1B=0;			// Stop the timer.
	TCNT1=0;			// Initialize the counter to 0.
	TIFR1=0xFF;			// Clear the interrupt flags by writing ones.
}

//-----------------------------------------------------------------------
// SD Memory/Filesystem handling:
//-----------------------------------------------------------------------
// Fri Jun 17 19:13:12 EDT 2011
// Update the state of the uSD card.  Detect and initialize it when it needs that kind of thing.
// Keep track of card validity and when the card is being accessed, etc etc
// WTPA2 TOC:
// ====================
// Block 0:
// 4 	chars 		"WTPA"
// 4	chars		Extended descriptor ("SAMP", "BOOT", "DPCM" -- indicates the type of data on the card)
// 8 	bytes 		don't care
// 64	bytes		Full/Empty sample slot info (512 bits which tell whether a sample is present or not in a slot)
// 432	bytes 		don't care

// Samples in SD-land:
// --------------------
// WTPA has a fifo in RAM which is 768 bytes long (1.5 blocks).
// Reading, we fill it a block (512 bytes) at a time.  When there is room for 512 bytes in the FIFO, we read the next block and continue doing this until the entire sample is read.
// In order to not hang our state machine for too long, a fraction of a block is read at a time.  This may cause trouble...  We'll see.
// Storing parameters works by storing the sample exactly as it is written to the DAC, meaning if the sample is stored backwards, it is written in from end to beginning.  When it's played back, it will play from beginning to end.
// Likewise, reducing bit depth or editing a sample will mean the sample is permanently stored that way when written to the SD.

// Sample Format:
// ---------------
// Sample format is currently:
// 4 bytes 	==	sample length
// n bytes	==	sample
// NOTE -- we handle the case where a sample + the four byte addy is bigger than a sample slot (512k) during the write routine by truncating the sample.  Sorry.

static void	ClearSampleToc(void)
// Empties the TOC of samples in local ram.
{
	unsigned char
		i;

	for(i=0;i<64;i++)			// For all TOC entries (64 bytes / 512 bits)
	{
		sampleToc[i]=0x00;		// 8 bits of "no sample present"
	}
}

static bool CheckSdSlotFull(unsigned int theSlot)
// Return true if the corresponding bit in the TOC is a 1.
// This is 64 bytes of 8 bits and we want to isolate the bit in question
{
	unsigned char
		theByte,
		theBit;

	theByte=theSlot/8;		// Get the byte the bit is in (ie, slot 1 is in 1/8 = byte 0)
	theBit=theSlot%8;		// Get the bit within the byte that is our flag (ie, slot one is 1 mod 8, or 1)

	if(sampleToc[theByte]&(1<<theBit))	// Bit is set?
	{
		return(true);
	}
	else
	{
		return(false);
	}
}

static void MarkSdSlotFull(unsigned int theSlot)
// Changes a bit in the TOC to a 1 to mark it full.
{
	unsigned char
		theByte,
		theBit;

	theByte=theSlot/8;		// Get the byte the bit is in (ie, slot 1 is in 1/8 = byte 0)
	theBit=theSlot%8;		// Get the bit within the byte that is our flag (ie, slot one is 1 mod 8, or 1)

	sampleToc[theByte]|=(1<<theBit);	// Set it
}

static void MarkSdSlotEmpty(unsigned int theSlot)
// Changes a bit in the TOC to a 0 to mark it empty.
{
	unsigned char
		theByte,
		theBit;

	theByte=theSlot/8;		// Get the byte the bit is in (ie, slot 1 is in 1/8 = byte 0)
	theBit=theSlot%8;		// Get the bit within the byte that is our flag (ie, slot one is 1 mod 8, or 1)

	sampleToc[theByte]&=~(1<<theBit);	// Clear it
}

enum							// The things we can recognize a card to be from it's header
	{
		SD_TYPE_UNFORMATTED=0,
		SD_TYPE_SAMPLES,
		SD_TYPE_DPCM,
		SD_TYPE_BOOT,
	};

static unsigned char GetCardFilesystem(void)
// Look for the tell tale signs of the party on this card.  If they are there, read in the TOC and return true.
{
	unsigned char
		filesystemType;
	unsigned char
		sdTypeBuffer[8];
	unsigned int
		i;

	filesystemType=SD_TYPE_UNFORMATTED;		// Start assuming no filesystem

	if(SdBeginSingleBlockRead(0)==true)		// Start reading at block 0.
	{
		// Wait for a data packet from the card.
		// EITHER read in the first four bytes then pull CS high  -- SD SPEC specifies that the SD card ALWAYS replies to SPI commands, so we could probably get away with this.  Could also do this, then read status to clear any error flags.
 		// Tue Jun 21 17:11:28 EDT 2011
 		// @@@ this appears to be bad news.  Tends to leave DO low.
		// So --
		// Read the first four bytes and test them, then read the remainder of the block and checksum and toss it.

		SetTimer(TIMER_SD,(SECOND/10));		// 100mSecs timeout

		while((!(CheckTimer(TIMER_SD)))&&(TransferSdByte(DUMMY_BYTE)!=0xFE))	// Wait for the start of the packet.  Could take 100mS
		{
			HandleSoftclock();	// Kludgy
		}

		for(i=0;i<8;i++)	// Get the first 8 bytes of the header and use them to determine the filesystem
		{
			sdTypeBuffer[i]=TransferSdByte(DUMMY_BYTE);
		}

		if((sdTypeBuffer[0]=='W')&&(sdTypeBuffer[1]=='T')&&(sdTypeBuffer[2]=='P')&&(sdTypeBuffer[3]=='A'))	// SOME kind of WTPA card, most likely (first four chars are always WTPA)
		{
			if((sdTypeBuffer[4]=='S')&&(sdTypeBuffer[5]=='A')&&(sdTypeBuffer[6]=='M')&&(sdTypeBuffer[7]=='P'))		// Samples?
			{
				filesystemType=SD_TYPE_SAMPLES;
			}
			else if((sdTypeBuffer[4]=='D')&&(sdTypeBuffer[5]=='P')&&(sdTypeBuffer[6]=='C')&&(sdTypeBuffer[7]=='M'))	// Andrew's Nintendo DPCM samples?
			{
				filesystemType=SD_TYPE_DPCM;
			}
			else if((sdTypeBuffer[4]=='B')&&(sdTypeBuffer[5]=='O')&&(sdTypeBuffer[6]=='O')&&(sdTypeBuffer[7]=='T'))	// Program image for bootloader?
			{
				filesystemType=SD_TYPE_BOOT;
			}
		}

		for(i=0;i<8;i++)					// 8 don't care bytes left (16 bytes at the beginning of the card for a string)
		{
			TransferSdByte(0xFF);
		}

		if(filesystemType==SD_TYPE_SAMPLES)				// Load TOC if this is a legit card
		{
			for(i=0;i<64;i++)							// For all TOC entries (64 bytes / 512 bits)
			{
				sampleToc[i]=TransferSdByte(0xFF);		// Load toc into RAM
			}
		}
		else
		{
			for(i=0;i<64;i++)				// Get bytes but don't put them in the toc
			{
				TransferSdByte(0xFF);
			}

		}
		for(i=0;i<(432+2);i++)					// Read don't cares and CRC
		{
			TransferSdByte(0xFF);
		}
	}

	while(!(UCSR1A&(1<<TXC1)))	// Spin until the last clocks go out
		;

	EndSdTransfer();				// Bring CS high
	TransferSdByte(DUMMY_BYTE);		// Send some clocks to make sure the state machine gets back to where it needs to go.

	return(filesystemType);
}

static void DoFormatCard(void)
// We get here if the card has something other than the WTPA filesystem on it (like, say, FAT16)
// Give the user the option to purge the card of its evil ways, and do so and reboot.
{
	if(subState==SS_0)
	{
		KillLeds();		// Turn off LEDs

		bankStates[BANK_0].audioFunction=AUDIO_IDLE;	// Stop audio ISRs
		bankStates[BANK_0].clockMode=CLK_NONE;
		bankStates[BANK_1].audioFunction=AUDIO_IDLE;
		bankStates[BANK_1].clockMode=CLK_NONE;

		BlinkLeds((1<<LED_0)|(1<<LED_7));	// Blink Leds 0, 7 to show the user something serious is going down
		subState=SS_1;
	}
	else if(subState==SS_1)
	{
		if((keyState&Im_SWITCH_0)&&(keyState&Im_SWITCH_7))	// Both buttons pressed?
		{
			cardState=SD_TOC_WRITE_START;	// Start TOC write
			KillLeds();
			ledOnOffMask|=(1<<LED_0)|(1<<LED_7);	// Turn both LEDs on while write occurs
			subState=SS_2;
		}
		else if(cardState==SD_NOT_PRESENT)	// We pulled the SD card.  Reset sampler
		{
			SetState(DoFruitcakeIntro);	// Yep, start sampler over again.
		}
	}
	else if(subState==SS_2)
	{
		if(cardState==SD_IDLE)	// Got what we wanted?
		{
			KillLeds();
			ledOnOffMask|=(1<<LED_1);
			if(cardState==SD_NOT_PRESENT||newKeys)		// We pulled the SD card or hit a key.
			{
				SetState(DoFruitcakeIntro);	// Start sampler over again.
			}
		}
	}
}

static bool SdStartSampleRead(unsigned int sampleSlot)
// Initializes the state machine and FIFOs for reading in a sample from the SD into RAM.
// Begins a sample read in the correct spot.
// NOTE -- card must be present and not busy to do this.  Caller's reponsibility to check this.
{
	unsigned char
		sreg;

	sreg=SREG;
	cli();		// Pause ISR

	if(SdBeginSingleBlockRead(1+(sampleSlot*1024))==true)	// Try to open the card for a single block read (*1024 to give 512k sample slots)
	{
		sdSampleStartBlock=(1+(sampleSlot*1024));	// Mark this block as where we started reading (1 block plus 512k sample size times the number of samples in we are)
		sdCurrentBlockOffset=0;						// Read first block first

		sdFifoReadPointer=0;		// Reset FIFO variables
		sdFifoWritePointer=0;
		sdBytesInFifo=0;

		SetTimer(TIMER_SD,(SECOND/10));			// 100 mS timeout (God Forbid)
		cardState=SD_READ_START;				// Read in the first sample block with the state machine

		SREG=sreg;	// Resume ISR

		return(true);
	}
	SREG=sreg;	// Resume ISR
	return(false);
}

static void SdStartSampleWrite(unsigned int sampleSlot, unsigned long sampleLength)
// Initializes the state machine and FIFOs for writing a sample to the SD card
// NOTE -- card must be present and not busy to do this.  Caller's reponsibility to check this.
// Thu Jun 23 00:46:03 EDT 2011 -- by using single block writes, this is REALLY slow.
{
	unsigned char
		sreg;

	sreg=SREG;
	cli();		// Pause ISR

	sdCurrentSlot=sampleSlot;					// Need this to know whether to update TOC
	sdSampleStartBlock=(1+(sampleSlot*1024));	// Mark this block as where we started reading (1 block plus 512k sample size times the number of samples in we are)
	sdCurrentBlockOffset=0;						// Offset to start block -- write first block first.

	sdFifoReadPointer=0;		// Reset FIFO variables
	sdFifoWritePointer=0;
	sdBytesInFifo=0;

	if(sampleLength<=((512UL*1024UL)-4))		// Allow for weird case where sample + 4 byte address would be bigger than a slot (bigger than 512k)
	{
		sdRamSampleRemaining=sampleLength;				// How many bytes in this sample?  Mark this many to get from RAM
	}
	else
	{
		sdRamSampleRemaining=((512UL*1024UL)-4);		// Shave off last bytes.
	}

	sdCardSampleRemaining=sdRamSampleRemaining;		// At the start of the transfer, bytes to read from SRAM = bytes to write to card = sample length.
	cardState=SD_WRITE_START;						// Enable state machine to handle this.  NOTE -- we'll have to have a block in the FIFO before we start
	SREG=sreg;	// Resume ISR
}

static void ResetSdCard(void)
// If we unceremoniously pull a card, do this.
{
	unsigned char
		sreg;

	sreg=SREG;
	cli();

	EndSdTransfer();		// Bring CS high.  This will fuck things up if the card is mid transfer.
	ClearSampleToc();

	// Stop SD card ISR

	sdIsrState=SD_ISR_IDLE;		// ISR state to idle
	TCCR2B=0;					// Stop this timer
	TIMSK2&=~(1<<OCIE2B);		// Disable interrupt

	// Set this contribution to the DAC to midscale (this output source is now quiet)
	sdStreamOutput=0;

	sdFifoReadPointer=0;		// Reset FIFO variables
	sdFifoWritePointer=0;
	sdBytesInFifo=0;

	InitSdInterface();
	cardState=SD_NOT_PRESENT;	// Mark the card as st elsewhere

	SREG=sreg;
}

static void UpdateCard(void)
// Updates the state machine which keeps the card reads/writes/inits going like they should.
{
	unsigned char
		theByte,
		sreg,
		i;

	signed char
		tempSample;		// Must be signed or we can get bit errors (will hold ADC data most of the time)

	unsigned int
		numTransferBytes;

	static unsigned int
		bytesLeftInBlock;	// How many bytes left in the given block

	if(cardDetect==false)		// No card in the slot?
	{
		if(cardState!=SD_NOT_PRESENT)	// Was there a card in the slot before?
		{
			ResetSdCard();	// Uninit any filesystem shizz, stop any transfers in progress gracefully
		}
	}
	else	// Yup, got a card
	{
		switch(cardState)
		{

// --------------------------------------------------------------------------------------------------------------------------------------
// Warmup / Init	---------------------------------------------------------------------------------------------------------
// --------------------------------------------------------------------------------------------------------------------------------------

			case SD_JUST_INSERTED:	// Just went into slot
			cardState=SD_WARMUP;	// Let card get power settled before trying to do anything.
			SetTimer(TIMER_SD,SD_WARMUP_TIME);		// Give card this long
			break;

			case SD_WARMUP:				// Card inserted, timer has been started.
			if(CheckTimer(TIMER_SD))	// Card had long enough to power up?
			{
				sdPlaybackQueued=false;
				sdAbortRead=false;

				if(SdHandshake()==true)				// See if this is a valid SD standard capacity card that we can talk to.
				{
					theByte=GetCardFilesystem();	// Can talk to it.  Try and figure out the type of data that might be on the card.

					if(theByte==SD_TYPE_SAMPLES)	// Looks like WTPA-formatted samples.
					{
						if(dpcmMode==true)
						{
							cli();
							asm volatile("jmp 0000");	// Jump to normal reset vector -- start application
						}
						else
						{
							cardState=SD_IDLE;			// Card is legit and ready to go.
							InitSdIsr();				// Enable the timers necessary to give the SD card its own IRQ						
						}

					}
					else if(theByte==SD_TYPE_DPCM)	// Looks like Nintendo samples, uninitialize the normal sampler routines and get that going.
					{
						InitDpcm();					// WOOO LETS GET TRIFORCE TATTOOS! 
						cardState=SD_IDLE;			// Card is legit and ready to go.
					}
					else	// Valid card, but either invalid filesystem or BOOT card.  Vector to "are you sure" state and give user the option to Format the card.
					{
						cardState=SD_INVALID;	// Don't let the state machine mess with the card while it's being Formatted.
						ClearSampleToc();		// Write toc to zero
						SetState(DoFormatCard);	// Go here and let the user decide if they REALLY want to commit to making this a WTPA specific card
					}
				}
				else	// Not a valid handshake.  Get on with our lives.
				{
					cardState=SD_INVALID;
				}
			}
			break;

// --------------------------------------------------------------------------------------------------------------------------------------
// Writing Samples to the Card	---------------------------------------------------------------------------------------------------------
// --------------------------------------------------------------------------------------------------------------------------------------

			case SD_WRITE_START:		// Wait until the fifo has a block, then start the write beginning with the length of the sample.
			sreg=SREG;					// Pause ISR since ISR can be messing with the following variable
			cli();
			if((sdBytesInFifo>=SD_BLOCK_LENGTH)||(sdBytesInFifo>=sdCardSampleRemaining))	// Fifo has full block OR our sample is less than a block AND loaded in the FIFO.
			{
				SREG=sreg;	// Done reading ISR variables.
				if(SdBeginSingleBlockWrite(sdSampleStartBlock)==true)	// Try to open the card for a single block write.
				{
					bytesLeftInBlock=SD_BLOCK_LENGTH;			// Entire block left

					TransferSdByte(DUMMY_BYTE);							// Send a pad
					TransferSdByte(DUMMY_BYTE);							// Send another pad
					TransferSdByte(0xFE);								// Send DATA_START token
					TransferSdByte((sdCardSampleRemaining>>24)&0xFF);		// Sample length MSB
					TransferSdByte((sdCardSampleRemaining>>16)&0xFF);		// Sample length
					TransferSdByte((sdCardSampleRemaining>>8)&0xFF);		// Sample length
					TransferSdByte(sdCardSampleRemaining&0xFF);				// Sample length LSB

					bytesLeftInBlock-=4;							// Keep track of where we are in the block

					cardState=SD_WRITING_BLOCK;				// Took care of weird first transfer, now worry about writing out sample data
				}
				else // Couldn't open card for write
				{
					ResetSdCard();	// Uninit any filesystem shizz, stop any transfers in progress gracefully
				}
			}
			else	// Fifo not ready yet
			{
				SREG=sreg;	// Turn ISR back on
			}
			break;

			case SD_WRITING_BLOCK:										// The SD card is open and we're currently writing a block.
			if(bytesLeftInBlock>SD_BYTES_PER_PARTIAL_BLOCK_TRANSFER)	// More than a chunk left in the block, send a chunk.
			{
				numTransferBytes=SD_BYTES_PER_PARTIAL_BLOCK_TRANSFER;
			}
			else	// Less than a chunk left in the block, send the rest of the block.
			{
				numTransferBytes=bytesLeftInBlock;
			}

			for(i=0;i<numTransferBytes;i++)				// Loop through bytes to send to card (note, this executes zero times if there are no bytes left)
			{
				if(sdCardSampleRemaining)							// Bytes left in our sample?  If so, write them.
				{
					TransferSdByte(sdFifo[sdFifoReadPointer]);		// Put byte from fifo into SD
					sdCardSampleRemaining--;						// One less sample byte to go into the card

					sdFifoReadPointer++;			// Move to next spot in fifo

					if(sdFifoReadPointer>=SD_FIFO_SIZE)	// Handle wrapping around end of fifo
					{
						sdFifoReadPointer=0;
					}

					sreg=SREG;			// Pause ISR since ISR can be messing with the following variable
					cli();
					sdBytesInFifo--;	// Stored one more byte.
					SREG=sreg;
				}
				else	// If sample has been loaded already
				{
					TransferSdByte(DUMMY_BYTE);		// Send a padding byte to the SD
				}

				bytesLeftInBlock--;			// One less byte in the block write.
			}

			// Have we written an entire block?
			if(bytesLeftInBlock==0)		// Handle closing this block
			{
				TransferSdByte(DUMMY_BYTE);				// Send poo poo checksum
				TransferSdByte(DUMMY_BYTE);				// Send poo poo checksum
				theByte=(TransferSdByte(DUMMY_BYTE)&0x1F);	//	Get Error code

				if(theByte==0x05)							// 	A good write!  Expect to be busy for a long time.
				{
					SetTimer(TIMER_SD,(SECOND/2));			// 500mS timeout, card is busy.
					cardState=SD_WRITE_CARD_WAIT;			// Hang while card is writing and wait until we can move on.
				}
				else	// Something wrong with the write.
				{
					ResetSdCard();	// Uninit any filesystem shizz, stop any transfers in progress gracefully
				}
			}
			break;

			case SD_WRITE_CARD_WAIT:				// The SD card is spinning and we're waiting on it to continue writing (or ending the sample transfer)
			if(!(CheckTimer(TIMER_SD)))				// Didn't timeout yet
			{
				i=0;
				while(i<4)		// Try a few times to see if the card is done writing
				{
					theByte=TransferSdByte(DUMMY_BYTE);	// Check card
					if(theByte!=0xFF)					// Line should send zeros while programming, and send return high when programming is done.
					{
						i++;	// Try again.
					}
					else
					{
						i=4;	// Got a result, stop polling
					}
				}

				if(theByte==0xFF)	// Got a proper reply (line idle), end transfer and figure what to do next.
				{
					EndSdTransfer();				// Bring CS high
					TransferSdByte(DUMMY_BYTE);		// Send some clocks to make sure the state machine gets back to where it needs to go.
					while(!(UCSR1A&(1<<TXC1)))		// Spin until the last clocks go out
						;

					if(sdCardSampleRemaining)	// This block is done.  Any bytes still need to be written to the card?
					{
						cardState=SD_WRITE_FIFO_WAIT;	// Poll the FIFO until we have enough bytes in it to start another block write
					}
					else	// We've written the entire sample to the SD card, and the SD card block write is done.  Write the TOC if needed.
					{
						if(!(CheckSdSlotFull(sdCurrentSlot)))		// Don't bother updating TOC on SD if this slot is already full.
						{
							MarkSdSlotFull(sdCurrentSlot);			// Update toc on card to show that this slot has been filled.
							cardState=SD_TOC_WRITE_START;					// Now write the table of contents
						}
						else
						{
							cardState=SD_IDLE;				// DONE!
						}
					}
				}
			}
			else	// Timed out waiting for block to write.
			{
				ResetSdCard();	// Uninit any filesystem shizz, stop any transfers in progress gracefully
			}
			break;

			case SD_WRITE_FIFO_WAIT:		// After we write a block to the card, we wait for the fifo to be full (or full enough) to do another block write.
			sreg=SREG;						// Pause ISR since ISR can be messing with the following variable
			cli();
			if((sdBytesInFifo>=SD_BLOCK_LENGTH)||(sdBytesInFifo>=sdCardSampleRemaining))	// Fifo has full block OR what's left of the sample is less than a block AND loaded in the FIFO.
			{
				SREG=sreg;																	// Done reading ISR variables.
				sdCurrentBlockOffset++;		// On to the next

				if(SdBeginSingleBlockWrite(sdSampleStartBlock+sdCurrentBlockOffset)==true)	// Try to open the card for a single block write.
				{
					bytesLeftInBlock=SD_BLOCK_LENGTH;			// Entire block left

					TransferSdByte(DUMMY_BYTE);			// Send a pad
					TransferSdByte(DUMMY_BYTE);			// Send another pad
					TransferSdByte(0xFE);				// Send DATA_START token
					cardState=SD_WRITING_BLOCK;			// Return to regular write state (fifo has filled)
				}
				else	// Couldn't successfully open block to write
				{
					ResetSdCard();	// Uninit any filesystem shizz, stop any transfers in progress gracefully
				}
			}
			else	// Bytes remaining in sample, but not enough in the fifo yet
			{
				SREG=sreg;			// Done reading ISR variables.
			}
			break;

// --------------------------------------------------------------------------------------------------------------------------------------
// Writing TOC to the Card	-------------------------------------------------------------------------------------------------------------
// --------------------------------------------------------------------------------------------------------------------------------------

			case SD_TOC_WRITE_START:					// Write important stuff to TOC first, then transfer the rest via normal write procedure
			if(SdBeginSingleBlockWrite(0)==true)		// Start writing to block 0.
			{
				bytesLeftInBlock=SD_BLOCK_LENGTH;	// Whole block left

				TransferSdByte(DUMMY_BYTE);			// Send a pad
				TransferSdByte(DUMMY_BYTE);			// Send another pad
				TransferSdByte(0xFE);				// Send DATA_START token
				TransferSdByte('W');				// Write out string to indicate that this is a WTPA card
				TransferSdByte('T');
				TransferSdByte('P');
				TransferSdByte('A');
				TransferSdByte('S');				// These four characters indicate this card holds sample data (as opposed to Nintendo DPCMs, or a boot image)
				TransferSdByte('A');
				TransferSdByte('M');
				TransferSdByte('P');

				bytesLeftInBlock-=8;

				for(i=0;i<8;i++)					// 8 don't care bytes
				{
					TransferSdByte('x');
				}

				bytesLeftInBlock-=8;

				for(i=0;i<64;i++)					// Write table of contents.
				{
					TransferSdByte(sampleToc[i]);
				}

				bytesLeftInBlock-=64;						// shave off bytes from block counter
				cardState=SD_TOC_WRITE_CONTINUE;			// Now update the rest of the TOC block until it is full.
			}
			else	// Block write failed
			{
				ResetSdCard();	// Uninit any filesystem shizz, stop any transfers in progress gracefully
			}
			break;

			case SD_TOC_WRITE_CONTINUE:				// Keep writing don't cares to the block until we're done.
			if(bytesLeftInBlock>SD_BYTES_PER_PARTIAL_BLOCK_TRANSFER)	// More than a chunk left in the block, send a chunk.
			{
				numTransferBytes=SD_BYTES_PER_PARTIAL_BLOCK_TRANSFER;
			}
			else	// Less than a chunk left in the block, send the rest of the block.
			{
				numTransferBytes=bytesLeftInBlock;
			}

			for(i=0;i<numTransferBytes;i++)
			{
				TransferSdByte(DUMMY_BYTE);			// Send a pad
				bytesLeftInBlock--;					// One less byte to send.
			}

			if(bytesLeftInBlock==0)					// Handle closing this block
			{
				TransferSdByte(DUMMY_BYTE);				// Send poo poo checksum
				TransferSdByte(DUMMY_BYTE);				// Send poo poo checksum
				theByte=(TransferSdByte(DUMMY_BYTE)&0x1F);	//	Get Error code

				if(theByte==0x05)							// 	A good write!  Expect to be busy for a long time.
				{
					SetTimer(TIMER_SD,(SECOND/2));			// 500mS timeout, card is busy.
					cardState=SD_TOC_WRITE_FINISH;			// Now wait for the TOC to get done writing
				}
				else	// Something wrong with the write.
				{
					ResetSdCard();	// Uninit any filesystem shizz, stop any transfers in progress gracefully
				}
			}
			break;

			case SD_TOC_WRITE_FINISH:			// Spin until the TOC has finished writing.
			if(!(CheckTimer(TIMER_SD)))			// Didn't timeout yet
			{
				i=0;
				while(i<4)		// Try a few times to see if the card is done writing
				{
					theByte=TransferSdByte(DUMMY_BYTE);	// Check card
					if(theByte!=0xFF)					// Line should send zeros while programming, and send return high when programming is done.
					{
						i++;	// Try again.
					}
					else
					{
						i=4;	// Got a result, stop polling
					}
				}

				if(theByte==0xFF)	// Got a proper reply (line idle) end transfer mark IDLE
				{
					EndSdTransfer();				// Bring CS high
					TransferSdByte(DUMMY_BYTE);		// Send some clocks to make sure the state machine gets back to where it needs to go.
					while(!(UCSR1A&(1<<TXC1)))		// Spin until the last clocks go out
						;
					cardState=SD_IDLE;				// DONE!
				}
			}
			else	// Timed out waiting for block to write.
			{
				ResetSdCard();	// Uninit any filesystem shizz, stop any transfers in progress gracefully
			}
			break;
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
__attribute__ ((OS_main)) int main(void)		// OS_main tells us to not save registers upon entry.
// Initialize this mess.
{
	PRR=0xFF;			// Power off everything, let the initialization routines turn on modules you need.
	MCUCR&=~(1<<PUD);	// Globally enable pullups (we need them for the encoder)

	// Set the DDRs for all RAM, DAC, latch related pins here.  Any non-SFR related IO pin gets initialized here.  ADC and anything else with a specific init routine will be intialized separately.

	DDRC=0xCF;			// PORTC is the switch latch OE and direct address line outputs which must be initialized here.  PC4 is the interrupt-on-change input for the bank1 clock.  PC5 is the card detect input. Pins PC6-PC7 are unused now, so pull them low.
	PORTC=0x28;			// 0, 1, 2 are the address lines, pull them low.  Pull bit 3 high to tristate the switch latch.  Pull unused pins low.

	DDRD=0x80;			// PORTD is the UART (midi) the Flash interface (SPI) the ACLK input and the LED latch enable.  Make UART and Flash input for now and the rest make appropriate (LE is an output) .
	PORTD=0x00;			// Drive the LE for the LEDs low and leave the rest floating.

//	PORTA=0xC6;			// OE and WE high, latch enables low, no pullup on AIN0, pullups on the encoder pins.
	PORTA=0x06;			// OE and WE high, latch enables low, no pullup on AIN0, encoder now has hardware pullups.
	DDRA=0x3E;			// PORTA is digital outputs (latch strobe lines and OE/WE lines PA1-5), the analog in (on PA0) and the encoder inputs (PA6 and PA7)

	DDRB=0xFF;			// Latch port to OP.
	LATCH_PORT=128;		// And set it equal to midscale for the DAC.

	// Set the DAC to midscale to avoid pops on the first interrupt call.
	PORTA|=(Om_RAM_OE);		// Tristate the RAM.
	LATCH_DDR=0xFF;			// Turn the data bus around (AVR's data port to outputs)
	PORTA|=(Om_DAC_LA);		// Strobe dac latch enable high -- this puts the dacByte on the 373's output...
	PORTA&=~(Om_DAC_LA);	// ...And keeps it there.

	InitSdInterface();		// Turn on SD hardware
	InitSwitches();
	InitEncoder();
	InitLeds();
	InitMidi();					// Get the MIDI stack initialized.
	InitUart0();
//	InitUart1();
	InitAdc();
	InitSoftclock();
//	InitRandom();
	InitSampleClock();	// Turns on TIMER1 and gets it ready to generate interrupts.

	newKeys=0;
	keyState=0;
	cardState=SD_NOT_PRESENT;	// No card yet
	cardDetect=false;
	dpcmMode=false;

	sei();						// THE ONLY PLACE we should globally enable interrupts in this code.

	SetState(DoFruitcakeIntro);	// Daze and Astound

	while(1)
	{
		HandleSwitches();		// Flag newKeys.
		HandleEncoder();		// Keep track of encoder states and increment values.
		HandleSoftclock();		// Keep the timer timing.
		HandleLeds();			// Keep LEDs updated.
		UpdateCard();			// Keep the SD card state machine running.
		GetRandomLongInt();		// Keep random numbers rolling.

//daNextJump=random31;
//daNextJumpPrime=(keyState+systemTicks);

		if(Uart0GotByte())		// Handle receiving midi messages: Parse any bytes coming in over the UART into MIDI messages we can use.
		{
			HandleIncomingMidiByte(Uart0GetByte());		// Deal with the UART message and put it in the incoming MIDI FIFO if relevant.
		}

		if(MidiTxBufferNotEmpty())			// Got something to say?
		{
			if(UCSR0A&(1<<UDRE0))			// UART0 ready to receive new data?
			{
				UDR0=PopOutgoingMidiByte();	// Get the next byte to send and push it over the UART
			}
		}

		State();				// Execute the current program state.
	}
	return(0);
}
