ToddBailey/WTPA2/bootloader_sd/softclock.h

//void ResetTimer(unsigned char timerNum);
void SetTimer(unsigned char timerNum, unsigned int ticks_to_wait);
unsigned char CheckTimer(unsigned char timerNum);
//void ExpireTimer(unsigned char timerNum);
