ToddBailey/WTPA2/(commit log)

2013-10-29 Made SD card reset more sensical, fixed SD contention with LED intro, made Makefiles load bootloader and app
    [WTPA.c, microSD.c]
2013-11-01 Fixed SD card filesystem to recognize different data types (like SAMPLE, BOOT, DPCM) and wrote SD card access menu
    [WTPA.c, globals.h]
2013-11-05 Reverted to previous ISR code; experiments had really slowed audio ISRs down a lot
    [defines.h]
2013-11-07 Finished integrating new audio engine and related code. Check for bugs, there are a couple obvious ones mostly to do with edit mode now.
    [WTPA.c, defines.h, globals.h]
2013-11-08 Added python packer with new header format / arguments / dummy checks. Added 128 samples from various games to play with.
2013-11-08 Fixed edit mode and backwards masking stuff, ISRs a bit slow now
    [WTPA.c]
2013-12-22 Added hardware directory
    [WheresThePartyAt.brd, WheresThePartyAt.sch]
2014-11-07 Fixed some style and formatting in the bootloader
    [wtpa2bootloader.c]
2014-11-08 Fixed some playback problems related to loopOnce flags
    [WTPA.c]
2014-11-09 Fixed window editing boundary check, now plays nice with all normal playback functions
    [WTPA.c]
2014-11-09 Can now granularize edited samples
2014-11-12 Wrote and tested sample to AIFF converter
2014-11-13 Added block device support for audio sample extractor
2014-11-19 Began sample packer, used wack opendir for sorting
2014-11-20 Updated AIFF to Sample packer, format checks contd
2014-11-21 Cleaned up sample packer, removed unused code and variables, added comments
2014-11-21 Incorporated DPCM functions to normal WTPA2, fixed dpcm packer some
    [WTPA.c, dpcm.c]
2014-11-22 Fixed bug where RAM accesses would step on cardDetect
    [WTPA.c]
2014-11-23 Fixed offset bug in MIDI SD Streaming playback
    [WTPA.c]
2014-12-18 Fixed DDR bug which messed up Bank1 sampling
    [WTPA.c]
2014-12-19 Added Assembly and Component Guide docs
2015-01-02 Added new rev of assembly docs
2015-02-21 Added DPCM packer and Eagle jack PCB files
    [WTPA2_Jack_PCB.brd, WTPA2_Jack_PCB.sch]
